batuhankemal/Development-of-an-infrared-array-sensor-integrated-laser-system/Data/Agar_Hyperthermia_ Algorithm_Validation_Experiment/Agar_Hyperthermia_ Algorithm_Validation_Experiment_16042024_R1.xlsx

Sheet: EXPERIMENT1
Current | 5.116 | IR_Temp | 25.4
Current | 5.116 | IR_Temp | 24.8
Current | 5.116 | IR_Temp | 25.4
Current | 5.116 | IR_Temp | 25.3
Current | 5.129 | IR_Temp | 24.8
Current | 5.129 | IR_Temp | 25.4
Current | 5.129 | IR_Temp | 25.1
Current | 5.129 | IR_Temp | 25.5
Current | 5.129 | IR_Temp | 24.9
Current | 5.129 | IR_Temp | 25.8
Current | 5.129 | IR_Temp | 25.6
Current | 5.136 | IR_Temp | 25.1
Current | 5.136 | IR_Temp | 25.5
Current | 5.149 | IR_Temp | 25.3
Current | 5.149 | IR_Temp | 25.2
Current | 5.155 | IR_Temp | 25.1
Current | 5.155 | IR_Temp | 25.8
Current | 5.149 | IR_Temp | 24.5
Current | 5.149 | IR_Temp | 25.5
Current | 5.155 | IR_Temp | 26.2
Current | 5.155 | IR_Temp | 25.5
Current | 5.142 | IR_Temp | 26
Current | 5.142 | IR_Temp | 26.1
Current | 5.168 | IR_Temp | 25.5
Current | 5.175 | IR_Temp | 26.2
Current | 5.188 | IR_Temp | 26.4
Current | 5.175 | IR_Temp | 26.1
Current | 5.155 | IR_Temp | 26.3
Current | 5.155 | IR_Temp | 26
Current | 5.149 | IR_Temp | 26.5
Current | 5.149 | IR_Temp | 25.7
Current | 5.149 | IR_Temp | 25.9
Current | 5.149 | IR_Temp | 25.9
Current | 5.142 | IR_Temp | 25.9
Current | 5.136 | IR_Temp | 26.2
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
