batuhankemal/Development-of-an-infrared-array-sensor-integrated-laser-system/Data/Lamb_liver_experiments/Lamb_Liver_50C_ Experiment/Lamb_Liver_50C_ Experiment_14042024_R1.xlsx

Sheet: EXPERIMENT1
Current | 5.123 | IR_Temp | 20.8
Current | 5.129 | IR_Temp | 21.2
Current | 5.136 | IR_Temp | 22.7
Current | 5.136 | IR_Temp | 22.7
Current | 5.136 | IR_Temp | 24.4
Current | 5.136 | IR_Temp | 25.4
Current | 5.136 | IR_Temp | 26.4
Current | 5.116 | IR_Temp | 27.1
Current | 5.123 | IR_Temp | 27.9
Current | 5.129 | IR_Temp | 28.7
Current | 5.129 | IR_Temp | 30
Current | 5.129 | IR_Temp | 30.3
Current | 5.129 | IR_Temp | 31.5
Current | 5.136 | IR_Temp | 31.8
Current | 5.136 | IR_Temp | 32.2
Current | 5.142 | IR_Temp | 32.5
Current | 5.136 | IR_Temp | 34
Current | 4.609 | IR_Temp | 34.8
Current | 4.615 | IR_Temp | 34.7
Current | 3.417 | IR_Temp | 35.8
Current | 3.222 | IR_Temp | 36.4
Current | 2.747 | IR_Temp | 36.7
Current | 2.936 | IR_Temp | 37.6
Current | 3.411 | IR_Temp | 38.2
Current | 3.216 | IR_Temp | 38.8
Current | 4.902 | IR_Temp | 40
Current | 2.747 | IR_Temp | 39.2
Current | 4.908 | IR_Temp | 39.7
Current | 2.942 | IR_Temp | 40.9
Current | 2.753 | IR_Temp | 41.4
Current | 2.76 | IR_Temp | 42.2
Current | 4.902 | IR_Temp | 42.4
Current | 3.945 | IR_Temp | 43
Current | 3.704 | IR_Temp | 42.7
Current | 2.519 | IR_Temp | 43.2
Current | 4.14 | IR_Temp | 43.7
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
