batuhankemal/Development-of-an-infrared-array-sensor-integrated-laser-system/Data/Lamb_liver_experiments/Lamb_Liver_50C_ Experiment/Lamb_Liver_50C_ Experiment_Constant_Power_15042024_R1.xlsx

Sheet: EXPERIMENT1
Current | 2.819 | IR_Temp | 20.9
Current | 2.825 | IR_Temp | 21.3
Current | 2.825 | IR_Temp | 22.1
Current | 2.825 | IR_Temp | 22.4
Current | 2.825 | IR_Temp | 22.6
Current | 2.825 | IR_Temp | 22.6
Current | 2.825 | IR_Temp | 23.5
Current | 2.832 | IR_Temp | 23
Current | 2.832 | IR_Temp | 24.6
Current | 2.832 | IR_Temp | 24.9
Current | 2.838 | IR_Temp | 25
Current | 2.838 | IR_Temp | 24.8
Current | 2.825 | IR_Temp | 25.4
Current | 2.819 | IR_Temp | 25.8
Current | 2.812 | IR_Temp | 26.1
Current | 2.819 | IR_Temp | 26.3
Current | 2.819 | IR_Temp | 26.5
Current | 2.819 | IR_Temp | 27.1
Current | 2.819 | IR_Temp | 26.6
Current | 2.825 | IR_Temp | 27.4
Current | 2.825 | IR_Temp | 27.6
Current | 2.825 | IR_Temp | 27.5
Current | 2.825 | IR_Temp | 28.5
Current | 2.825 | IR_Temp | 28.5
Current | 2.825 | IR_Temp | 28.5
Current | 2.832 | IR_Temp | 28.1
Current | 2.832 | IR_Temp | 29.2
Current | 2.832 | IR_Temp | 29.4
Current | 2.838 | IR_Temp | 29.1
Current | 2.832 | IR_Temp | 30
Current | 2.845 | IR_Temp | 29.9
Current | 2.858 | IR_Temp | 29.7
Current | 2.851 | IR_Temp | 30.1
Current | 2.851 | IR_Temp | 30.1
Current | 2.851 | IR_Temp | 30.3
Current | 2.851 | IR_Temp | 30.4
Current | 2.851 | IR_Temp | 30.3
Current | 2.851 | IR_Temp | 30.5
Current | 2.851 | IR_Temp | 31.1
Current | 2.851 | IR_Temp | 30.6
Current | 2.851 | IR_Temp | 30.6
Current | 2.851 | IR_Temp | 31.2
Current | 2.858 | IR_Temp | 31
Current | 2.858 | IR_Temp | 31.3
Current | 2.851 | IR_Temp | 31.6
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
 |  | IR_Temp | 49.5
 |  | IR_Temp | 49.5
 |  | IR_Temp | 49.6
 |  | IR_Temp | 48.9
 |  | IR_Temp | 49.4
 |  | IR_Temp | 49.5
 |  | IR_Temp | 49.1
 |  | IR_Temp | 49.5
 |  | IR_Temp | 49.5
 |  | IR_Temp | 49.4
 |  | IR_Temp | 49.8
 |  | IR_Temp | 49.3
 |  | IR_Temp | 49.7
 |  | IR_Temp | 49.8

Sheet: EXPERIMENT2
Current | 2.825 | IR_Temp | 20.7
Current | 2.825 | IR_Temp | 21
Current | 2.825 | IR_Temp | 21.9
Current | 2.838 | IR_Temp | 22
Current | 2.838 | IR_Temp | 22.2
Current | 2.825 | IR_Temp | 23.2
Current | 2.825 | IR_Temp | 23.2
Current | 2.832 | IR_Temp | 23.2
Current | 2.845 | IR_Temp | 24.1
Current | 2.838 | IR_Temp | 24.2
Current | 2.845 | IR_Temp | 25
Current | 2.832 | IR_Temp | 24.8
Current | 2.832 | IR_Temp | 25.2
Current | 2.825 | IR_Temp | 25.7
Current | 2.825 | IR_Temp | 26.2
Current | 2.832 | IR_Temp | 26.3
Current | 2.838 | IR_Temp | 26.2
Current | 2.838 | IR_Temp | 26.8
Current | 2.838 | IR_Temp | 26.9
Current | 2.832 | IR_Temp | 27.6
Current | 2.838 | IR_Temp | 27.5
Current | 2.838 | IR_Temp | 27.1
Current | 2.838 | IR_Temp | 27.7
Current | 2.832 | IR_Temp | 27.8
Current | 2.838 | IR_Temp | 28.9
Current | 2.851 | IR_Temp | 29
Current | 2.845 | IR_Temp | 28.8
Current | 2.838 | IR_Temp | 29.5
Current | 2.845 | IR_Temp | 28.6
Current | 2.845 | IR_Temp | 29.3
Current | 2.838 | IR_Temp | 29.7
Current | 2.845 | IR_Temp | 30.2
Current | 2.845 | IR_Temp | 30
Current | 2.838 | IR_Temp | 29.8
Current | 2.845 | IR_Temp | 30.3
Current | 2.851 | IR_Temp | 30.3
Current | 2.851 | IR_Temp | 30.9
Current | 2.851 | IR_Temp | 30.8
Current | 2.851 | IR_Temp | 30.8
Current | 2.851 | IR_Temp | 30.7
Current | 2.858 | IR_Temp | 31.7
Current | 2.851 | IR_Temp | 31.2
Current | 2.851 | IR_Temp | 31
Current | 2.845 | IR_Temp | 31.3
Current | 2.845 | IR_Temp | 32.2
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
 |  | IR_Temp | 49
 |  | IR_Temp | 48.7
 |  | IR_Temp | 48.5
 |  | IR_Temp | 49.1
 |  | IR_Temp | 48.5
 |  | IR_Temp | 48.9
 |  | IR_Temp | 48.7
 |  | IR_Temp | 48.8
 |  | IR_Temp | 49.5
 |  | IR_Temp | 48.8
 |  | IR_Temp | 48.9
 |  | IR_Temp | 49
 |  | IR_Temp | 49.1
 |  | IR_Temp | 48.9
 |  | IR_Temp | 48.8
 |  | IR_Temp | 48.9

Sheet: EXPERIMENT3
Current | 2.799 | IR_Temp | 21.3
Current | 2.812 | IR_Temp | 21.4
Current | 2.838 | IR_Temp | 22.5
Current | 2.838 | IR_Temp | 22.6
Current | 2.845 | IR_Temp | 22.9
Current | 2.845 | IR_Temp | 23.2
Current | 2.845 | IR_Temp | 23.9
Current | 2.845 | IR_Temp | 23.3
Current | 2.845 | IR_Temp | 24.3
Current | 2.819 | IR_Temp | 24.4
Current | 2.825 | IR_Temp | 25.2
Current | 2.825 | IR_Temp | 25
Current | 2.825 | IR_Temp | 24.8
Current | 2.825 | IR_Temp | 25.5
Current | 2.832 | IR_Temp | 26.1
Current | 2.832 | IR_Temp | 26
Current | 2.851 | IR_Temp | 25.5
Current | 2.851 | IR_Temp | 26.2
Current | 2.838 | IR_Temp | 27.1
Current | 2.858 | IR_Temp | 27.4
Current | 2.845 | IR_Temp | 26.6
Current | 2.838 | IR_Temp | 28
Current | 2.832 | IR_Temp | 27.6
Current | 2.838 | IR_Temp | 27.6
Current | 2.838 | IR_Temp | 28.4
Current | 2.838 | IR_Temp | 28.5
Current | 2.845 | IR_Temp | 29.1
Current | 2.838 | IR_Temp | 28.2
Current | 2.845 | IR_Temp | 28.1
Current | 2.845 | IR_Temp | 29.7
Current | 2.838 | IR_Temp | 29.6
Current | 2.845 | IR_Temp | 29.8
Current | 2.838 | IR_Temp | 29.7
Current | 2.851 | IR_Temp | 29.6
Current | 2.851 | IR_Temp | 30.4
Current | 2.845 | IR_Temp | 30.4
Current | 2.845 | IR_Temp | 30.4
Current | 2.845 | IR_Temp | 30.9
Current | 2.845 | IR_Temp | 30.7
Current | 2.845 | IR_Temp | 30.9
Current | 2.845 | IR_Temp | 31.7
Current | 2.845 | IR_Temp | 31.2
Current | 2.845 | IR_Temp | 31.3
Current | 2.851 | IR_Temp | 31.7
Current | 2.845 | IR_Temp | 31.6
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
 |  | IR_Temp | 49.3
 |  | IR_Temp | 49.7
 |  | IR_Temp | 49.6
 |  | IR_Temp | 49.6
 |  | IR_Temp | 49.9
 |  | IR_Temp | 49.4
 |  | IR_Temp | 49.2
 |  | IR_Temp | 49.6
 |  | IR_Temp | 49.7
 |  | IR_Temp | 49.9
 |  | IR_Temp | 49
 |  | IR_Temp | 49.3
 |  | IR_Temp | 49.6
 |  | IR_Temp | 49.2

Sheet: EXPERIMENT4
Current | 2.812 | IR_Temp | 19.9
Current | 2.819 | IR_Temp | 20.5
Current | 2.819 | IR_Temp | 21
Current | 2.819 | IR_Temp | 21.2
Current | 2.825 | IR_Temp | 21.8
Current | 2.819 | IR_Temp | 22.2
Current | 2.825 | IR_Temp | 22
Current | 2.825 | IR_Temp | 23.1
Current | 2.832 | IR_Temp | 23
Current | 2.825 | IR_Temp | 24
Current | 2.825 | IR_Temp | 23.5
Current | 2.832 | IR_Temp | 24
Current | 2.832 | IR_Temp | 25
Current | 2.832 | IR_Temp | 25.1
Current | 2.832 | IR_Temp | 25.3
Current | 2.832 | IR_Temp | 25
Current | 2.838 | IR_Temp | 25.4
Current | 2.832 | IR_Temp | 26.1
Current | 2.832 | IR_Temp | 26.1
Current | 2.832 | IR_Temp | 25.8
Current | 2.832 | IR_Temp | 26.1
Current | 2.838 | IR_Temp | 26.3
Current | 2.838 | IR_Temp | 27.8
Current | 2.838 | IR_Temp | 28
Current | 2.845 | IR_Temp | 27.2
Current | 2.838 | IR_Temp | 28.3
Current | 2.838 | IR_Temp | 28.2
Current | 2.845 | IR_Temp | 28.3
Current | 2.838 | IR_Temp | 29.4
Current | 2.838 | IR_Temp | 28.7
Current | 2.838 | IR_Temp | 29.3
Current | 2.838 | IR_Temp | 29.3
Current | 2.845 | IR_Temp | 29.7
Current | 2.845 | IR_Temp | 29.6
Current | 2.838 | IR_Temp | 29.9
Current | 2.845 | IR_Temp | 30.2
Current | 2.851 | IR_Temp | 30
Current | 2.838 | IR_Temp | 30.4
Current | 2.845 | IR_Temp | 30.4
Current | 2.832 | IR_Temp | 30.3
Current | 2.832 | IR_Temp | 30.7
Current | 2.825 | IR_Temp | 31.1
Current | 2.832 | IR_Temp | 30.9
Current | 2.832 | IR_Temp | 31.2
Current | 2.832 | IR_Temp | 31.2
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
 |  | IR_Temp | 51.1
 |  | IR_Temp | 50.5
 |  | IR_Temp | 50.9
 |  | IR_Temp | 50.6
 |  | IR_Temp | 50.7
 |  | IR_Temp | 50.5
 |  | IR_Temp | 50.1
 |  | IR_Temp | 50.6
 |  | IR_Temp | 49.9
 |  | IR_Temp | 50.6
 |  | IR_Temp | 50.6
 |  | IR_Temp | 51
 |  | IR_Temp | 50.9
 |  | IR_Temp | 50.6
