batuhankemal/Development-of-an-infrared-array-sensor-integrated-laser-system/Data/Lamb_liver_experiments/Lamb_Liver_60C_ Experiment/Lamb_Liver_60C_ Experiment_14042024_R1.xlsx

Sheet: EXPERIMENT1
Current | 5.11 | IR_Temp | 21.2
Current | 5.116 | IR_Temp | 21.7
Current | 5.116 | IR_Temp | 22.4
Current | 5.123 | IR_Temp | 23.3
Current | 5.129 | IR_Temp | 24.4
Current | 5.129 | IR_Temp | 25.4
Current | 5.136 | IR_Temp | 26.1
Current | 5.136 | IR_Temp | 27.2
Current | 5.136 | IR_Temp | 28.2
Current | 5.142 | IR_Temp | 28.7
Current | 5.149 | IR_Temp | 29.6
Current | 5.142 | IR_Temp | 30.1
Current | 5.11 | IR_Temp | 31.1
Current | 5.116 | IR_Temp | 31.8
Current | 5.142 | IR_Temp | 33.1
Current | 5.136 | IR_Temp | 33
Current | 5.136 | IR_Temp | 34.2
Current | 5.136 | IR_Temp | 34.2
Current | 5.142 | IR_Temp | 34.7
Current | 5.155 | IR_Temp | 35.5
Current | 5.162 | IR_Temp | 35.9
Current | 5.168 | IR_Temp | 36.8
Current | 5.168 | IR_Temp | 36.9
Current | 5.155 | IR_Temp | 37.4
Current | 5.142 | IR_Temp | 38.3
Current | 5.142 | IR_Temp | 38
Current | 5.149 | IR_Temp | 39.6
Current | 5.149 | IR_Temp | 39.8
Current | 5.142 | IR_Temp | 40.4
Current | 5.149 | IR_Temp | 41
Current | 5.155 | IR_Temp | 41.4
Current | 5.162 | IR_Temp | 41.8
Current | 5.168 | IR_Temp | 41.6
Current | 5.175 | IR_Temp | 42.5
Current | 5.181 | IR_Temp | 42.4
Current | 5.181 | IR_Temp | 42.8
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
