batuhankemal/Development-of-an-infrared-array-sensor-integrated-laser-system/Data/Lamb_liver_experiments/Lamb_Liver_50C_ Experiment/Lamb_Liver_50C_ Whole_Surface.xlsx

Sheet: EXPERIMENT1
21.1 | 22.2 | 23.8 | 25.2 | 23.7 | 25.2 | 24.6 | 23.8 | 25.4 | 23.9 | 27.1 | 25.3 | 26.3 | 26 | 27.1 | 25.7 | 25.4 | 26.6 | 26.2 | 26.3 | 25.4 | 24.6 | 23 | 23.6 | 22.4 | 24.1 | 23.5 | 22 | 23.8 | 23 | 22.5 | 23.7
23.3 | 23.7 | 23.9 | 24.8 | 24.3 | 24.8 | 27 | 26 | 27.1 | 25.9 | 25.9 | 26.7 | 26.8 | 27.6 | 27.2 | 27.7 | 27.3 | 26.4 | 28.7 | 27.3 | 27.5 | 26.2 | 24.7 | 24.8 | 24 | 23.7 | 23.3 | 23.2 | 22 | 25.3 | 23.9 | 24.5
23.8 | 24.9 | 24.4 | 24.1 | 25.5 | 26.3 | 25.9 | 26.1 | 27.1 | 27.3 | 25.8 | 26.7 | 28.6 | 28.3 | 29.5 | 28.6 | 28.7 | 29.2 | 28.8 | 28 | 28.6 | 27.2 | 25.5 | 24.4 | 24.6 | 23.5 | 24.7 | 23.1 | 22.8 | 23.7 | 23.5 | 25
23.1 | 24.9 | 26.1 | 24.8 | 26 | 25 | 26.8 | 27.6 | 26 | 28.7 | 27.6 | 28.1 | 30.7 | 31.3 | 29.6 | 29.4 | 30.6 | 29.4 | 30.6 | 29.3 | 28.7 | 28 | 27.3 | 28.2 | 27.4 | 25.4 | 24 | 24.6 | 22.7 | 24.3 | 24.4 | 22.4
24.3 | 23.3 | 23.5 | 24.8 | 24.5 | 25.8 | 27.2 | 27.6 | 26.5 | 29.1 | 30.1 | 30.6 | 30.2 | 31.3 | 30.9 | 32.6 | 30.7 | 31 | 30.1 | 31 | 29.7 | 28.7 | 28.3 | 27.1 | 26.1 | 26.3 | 24.9 | 23 | 25.3 | 24.1 | 24.6 | 24
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
