batuhankemal/Development-of-an-infrared-array-sensor-integrated-laser-system/Hardware/IR Array Unit Hardware/IR_ARRAY_IMG.brd

## EAGLE design Hardware/IR Array Unit Hardware/IR_ARRAY_IMG.brd (2024-10-23)

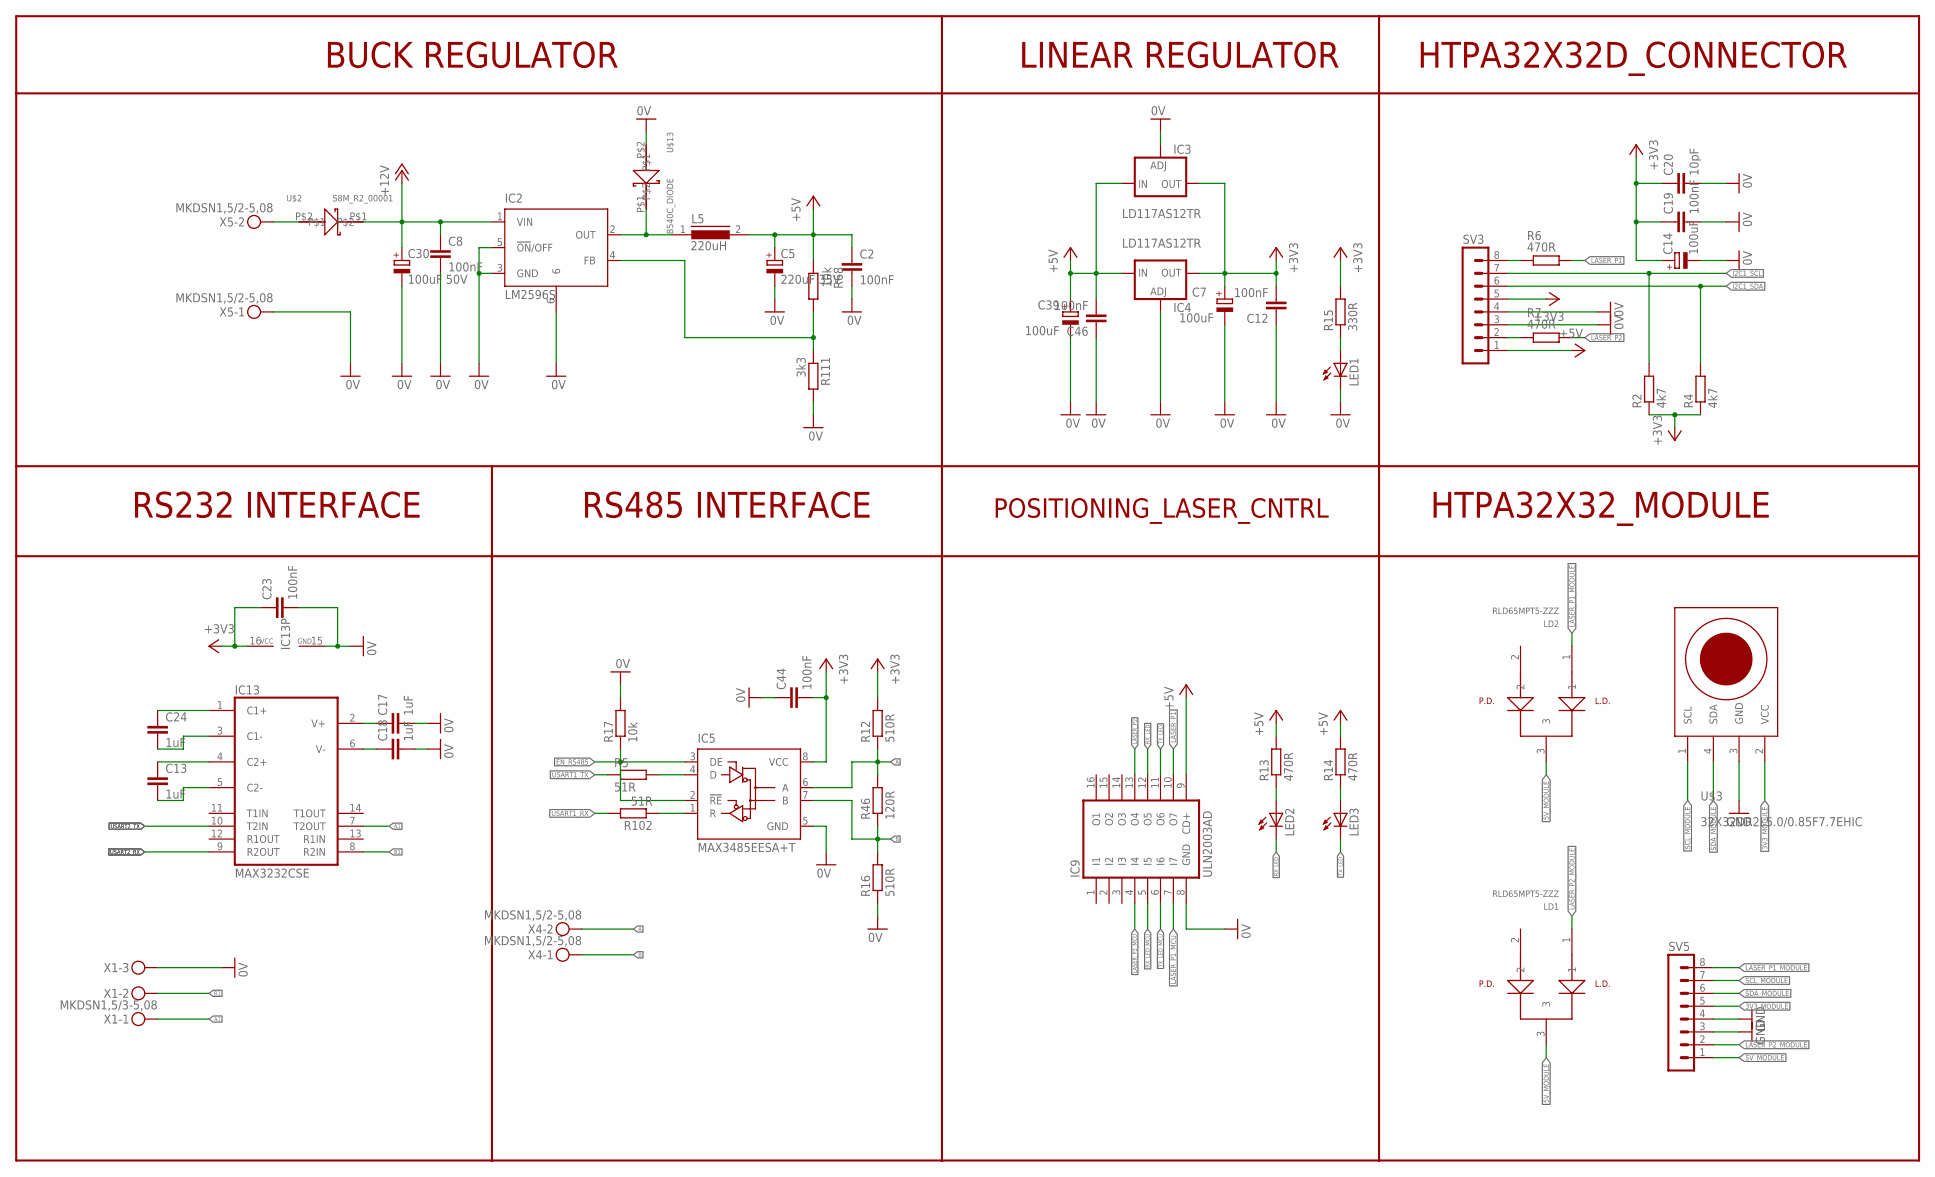
[picture p1: schematic IR_ARRAY_IMG.sch, sheet 1]

Parts:
C2, C8: 100nF; C0805
C5: 220uF 35V; 153CLV-0810
C7, C39: 100uF; 153CLV-0605
C12, C19, C23, C44, C46: 100nF; C0603
C13, C17, C18, C24: 1uF; C1206
C14: 100uF; C/6032-28R
C20: 10pF; C0603
C30: 100uF 50V; 153CLV-0810
IC2: LM2596S; TO263-5
IC3, IC4: LD117AS12TR; SOT223
IC5: MAX3485EESA+T; D_R-PDSO-G8
IC9: ULN2003AD; SO16
IC13: MAX3232CSE; SO16
L5: 220uH; DR125
LD1, LD2: RLD65MPT5-ZZZ
LED1, LED2, LED3: LEDCHIPLED_0805; CHIPLED_0805
R2, R4: 4k7; R0603
R5, R102: 51R; R0603
R6, R7: 470R; M0805
R12, R16: 510R; R0603
R13, R14: 470R; R0603
R15: 330R; R0603
R17: 10k; R0603
R46: 120R; R0603
R68: 10k; M0805
R111: 3k3; M0805
SV3, SV5: MA08-1
U$2: S8M_R2_00001; SMC
U$3: 32X32DR2L5.0/0.85F7.7EHIC
U$13: B540C_DIODE; SMC
X1: MKDSN1,5/3-5,08
X4, X5: MKDSN1,5/2-5,08

Connections:
0V: C2.2, C5.-, C7.-, C8.2, C12.1, C14.-, C17.2, C18.2, C19.2, C20.2, C23.2, C30.-, C39.-, C44.1, C46.1, IC2.3 (GND), IC2.5 (!ON!/OFF), IC2.6, IC3.1 (ADJ), IC4.1 (ADJ), IC5.5 (GND), IC9.8 (GND), IC13.15 (GND), LED1.C, R16.1, R17.2, R111.2, SV3.3, SV3.4, U$13.P$2, X1.3, X5.1; also elsewhere on the board
3V3_MODULE: SV5.5, U$3.2 (VCC)
5V_MODULE: LD1.3, LD2.3, SV5.1
+3V3: C7.+, C12.2, C14.+, C19.1, C20.1, C23.1, C44.2, IC3.4 (OUT), IC4.4 (OUT), IC5.8 (VCC), IC13.16 (VCC), R2.1, R4.1, R12.2, R15.2, SV3.5; also elsewhere on the board
+5V: C2.1, C5.+, C39.+, C46.2, IC3.3 (IN), IC4.3 (IN), IC9.9 (CD+), L5.2, R13.2, R14.2, R68.1, SV3.1
+12V: C8.1, C30.+, IC2.1 (VIN), U$2.P$1
A: IC5.6 (A), R12.1, R46.2, X4.2
A1: IC13.7 (T2OUT), X1.1
B: IC5.7 (B), R16.2, R46.1, X4.1
B1: IC13.8 (R2IN), X1.2
EN_RS485: IC5.2 (!RE), IC5.3 (DE), R17.1; also elsewhere on the board
GND: SV5.3, SV5.4, U$3.3 (GND)
I2C1_SCL: R2.2, SV3.7; also elsewhere on the board
I2C1_SDA: R4.2, SV3.6; also elsewhere on the board
LASER_P1: IC9.10 (O7), R6.2
LASER_P1_MCU: IC9.7 (I7); also elsewhere on the board
LASER_P1_MODULE: LD2.1, SV5.8
LASER_P2: IC9.13 (O4), R7.2
LASER_P2_MCU: IC9.4 (I4); also elsewhere on the board
LASER_P2_MODULE: LD1.1, SV5.2
unnamed: U$2.P$2, X5.2
unnamed: C18.1, IC13.6 (V-)
unnamed: R7.1, SV3.2
unnamed: R6.1, SV3.8
unnamed: LED2.A, R13.1
unnamed: LED3.A, R14.1
unnamed: IC5.4 (D), R5.2
unnamed: LED1.A, R15.1
unnamed: C24.1, IC13.1 (C1+)
unnamed: C24.2, IC13.3 (C1-)
unnamed: IC5.1 (R), R102.1
unnamed: C13.1, IC13.4 (C2+)
unnamed: C13.2, IC13.5 (C2-)
unnamed: C17.1, IC13.2 (V+)
unnamed: IC2.2 (OUT), L5.1, U$13.P$1
unnamed: IC2.4 (FB), R68.2, R111.1
RX_LED: IC9.12 (O5), LED2.C
RX_LED_MCU: IC9.5 (I5); also elsewhere on the board
SCL_MODULE: SV5.7, U$3.1 (SCL)
SDA_MODULE: SV5.6, U$3.4 (SDA)
TX_LED: IC9.11 (O6), LED3.C
TX_LED_MCU: IC9.6 (I6); also elsewhere on the board
USART1_RX: R102.2; also elsewhere on the board
USART1_TX: R5.1; also elsewhere on the board
USART2_RX: IC13.9 (R2OUT); also elsewhere on the board
USART2_TX: IC13.10 (T2IN); also elsewhere on the board

Notes on the sheet:
BUCK REGULATOR
LINEAR REGULATOR
RS232 INTERFACE
RS485 INTERFACE
HTPA32X32D_CONNECTOR
HTPA32X32_MODULE
POSITIONING_LASER_CNTRL

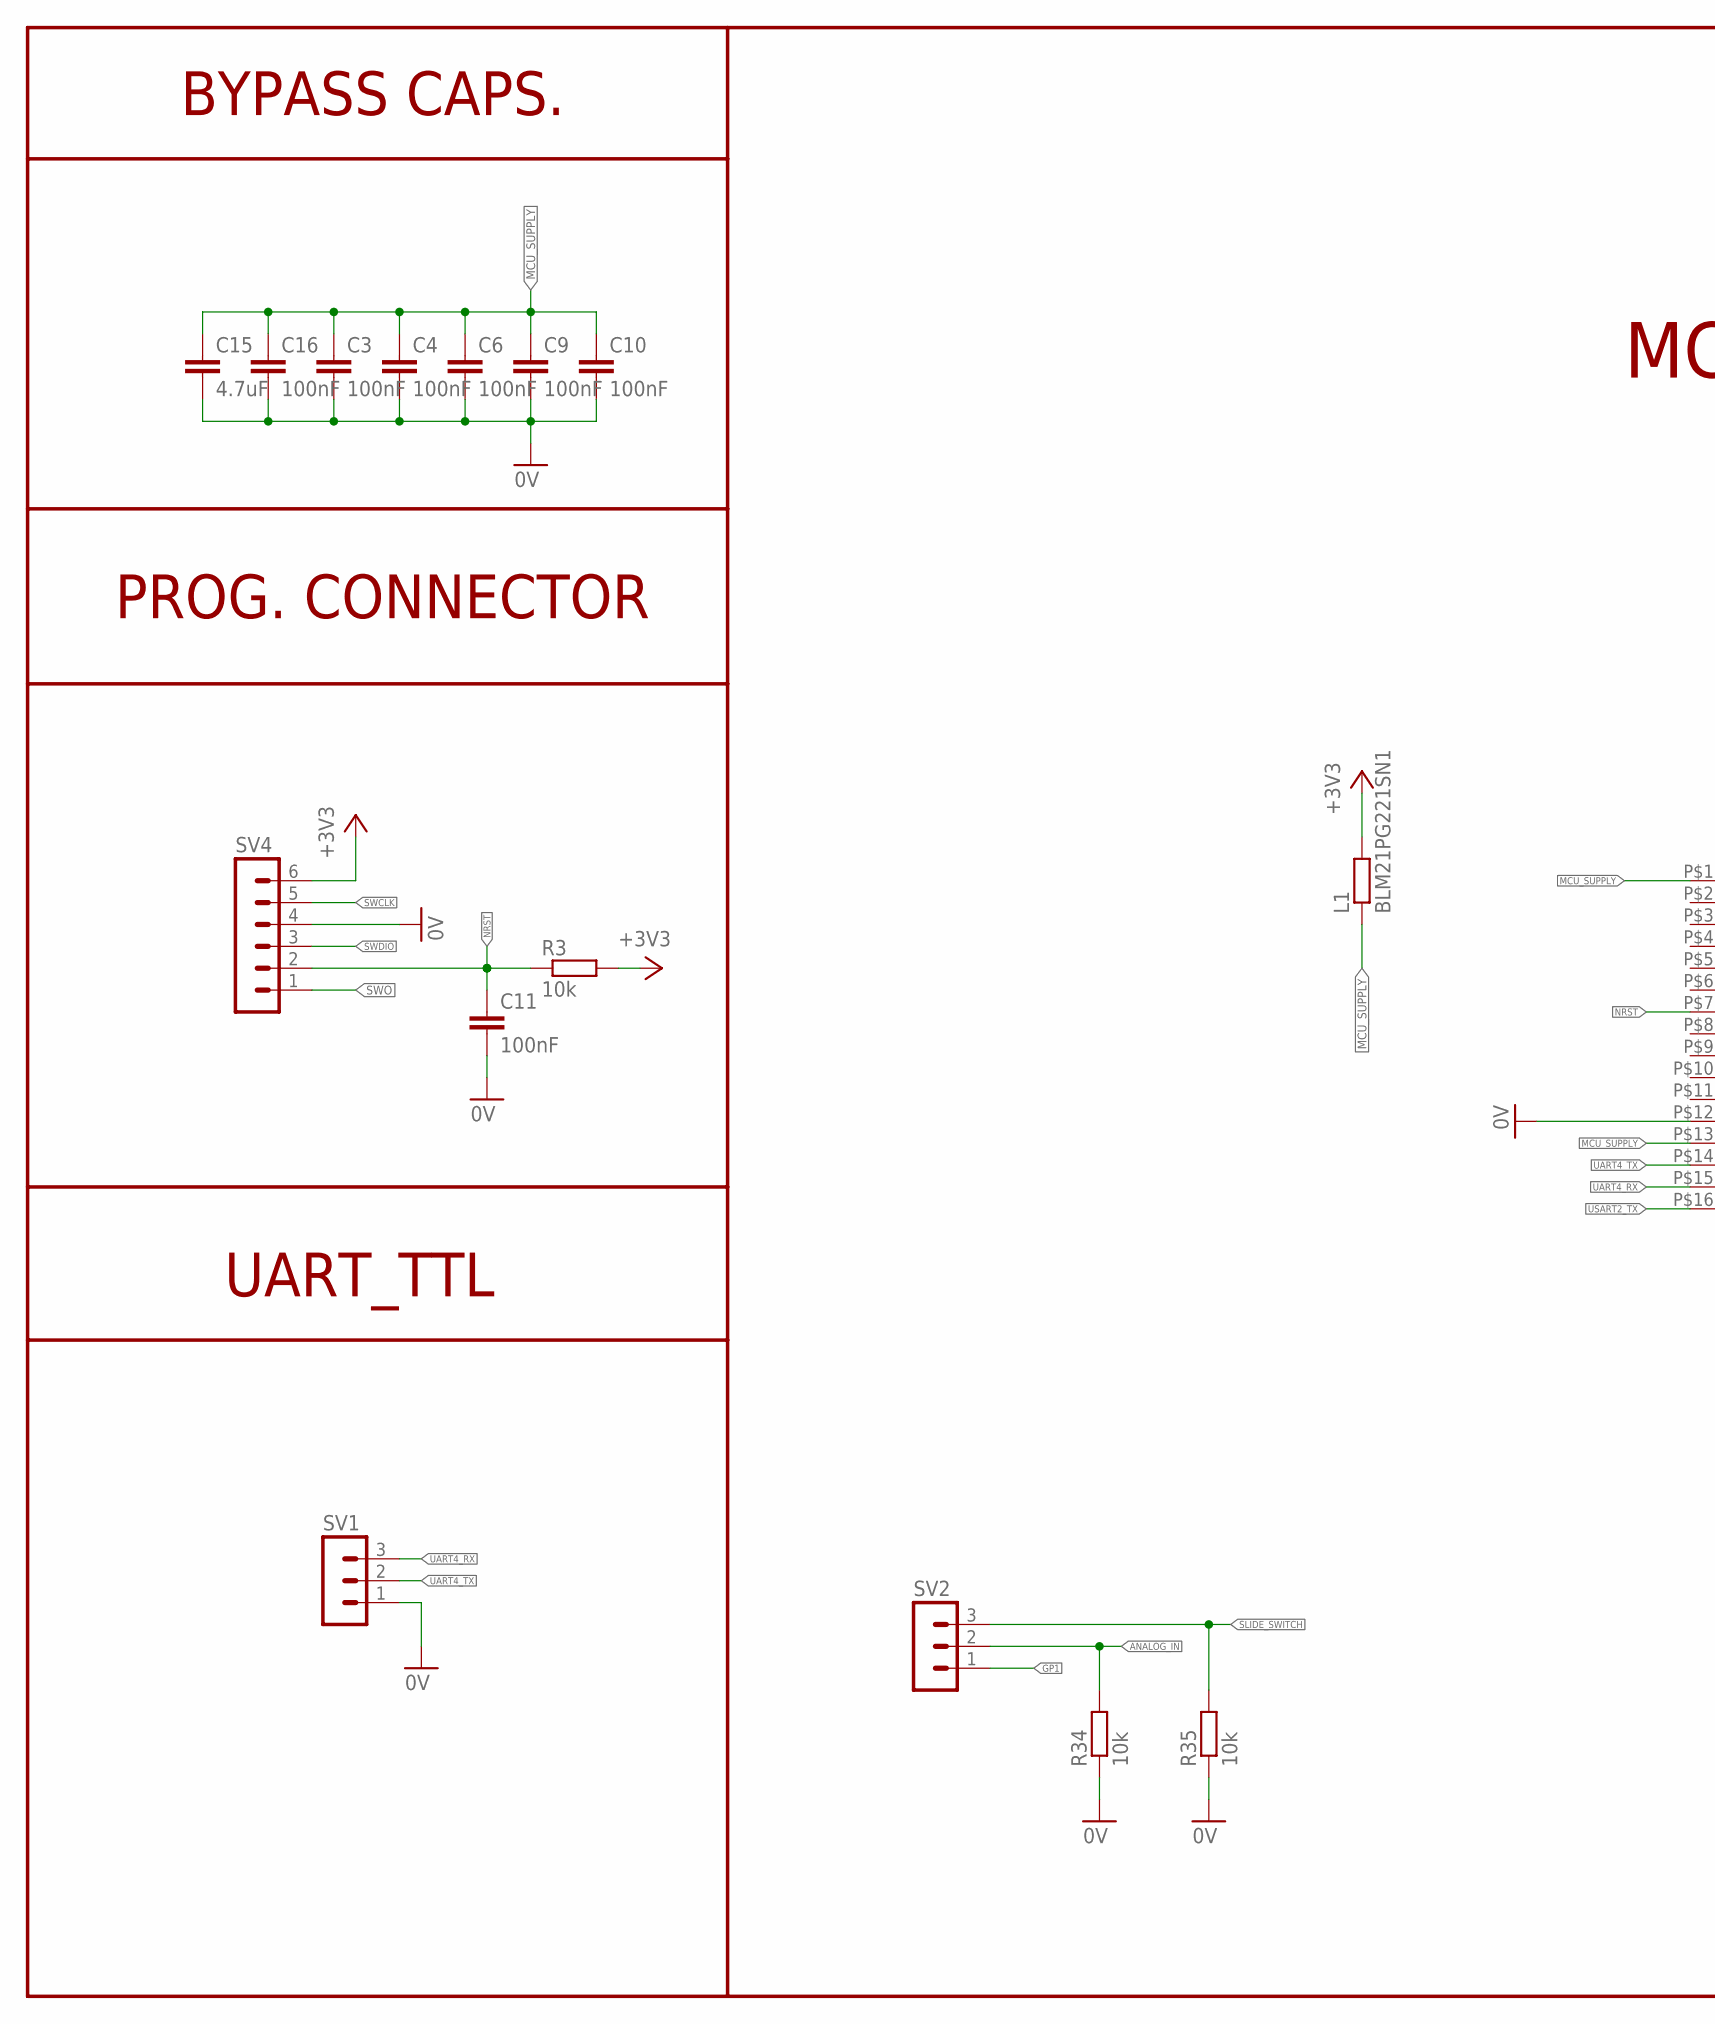
[picture p2: schematic IR_ARRAY_IMG.sch, sheet 2, part in row 1, column 1]

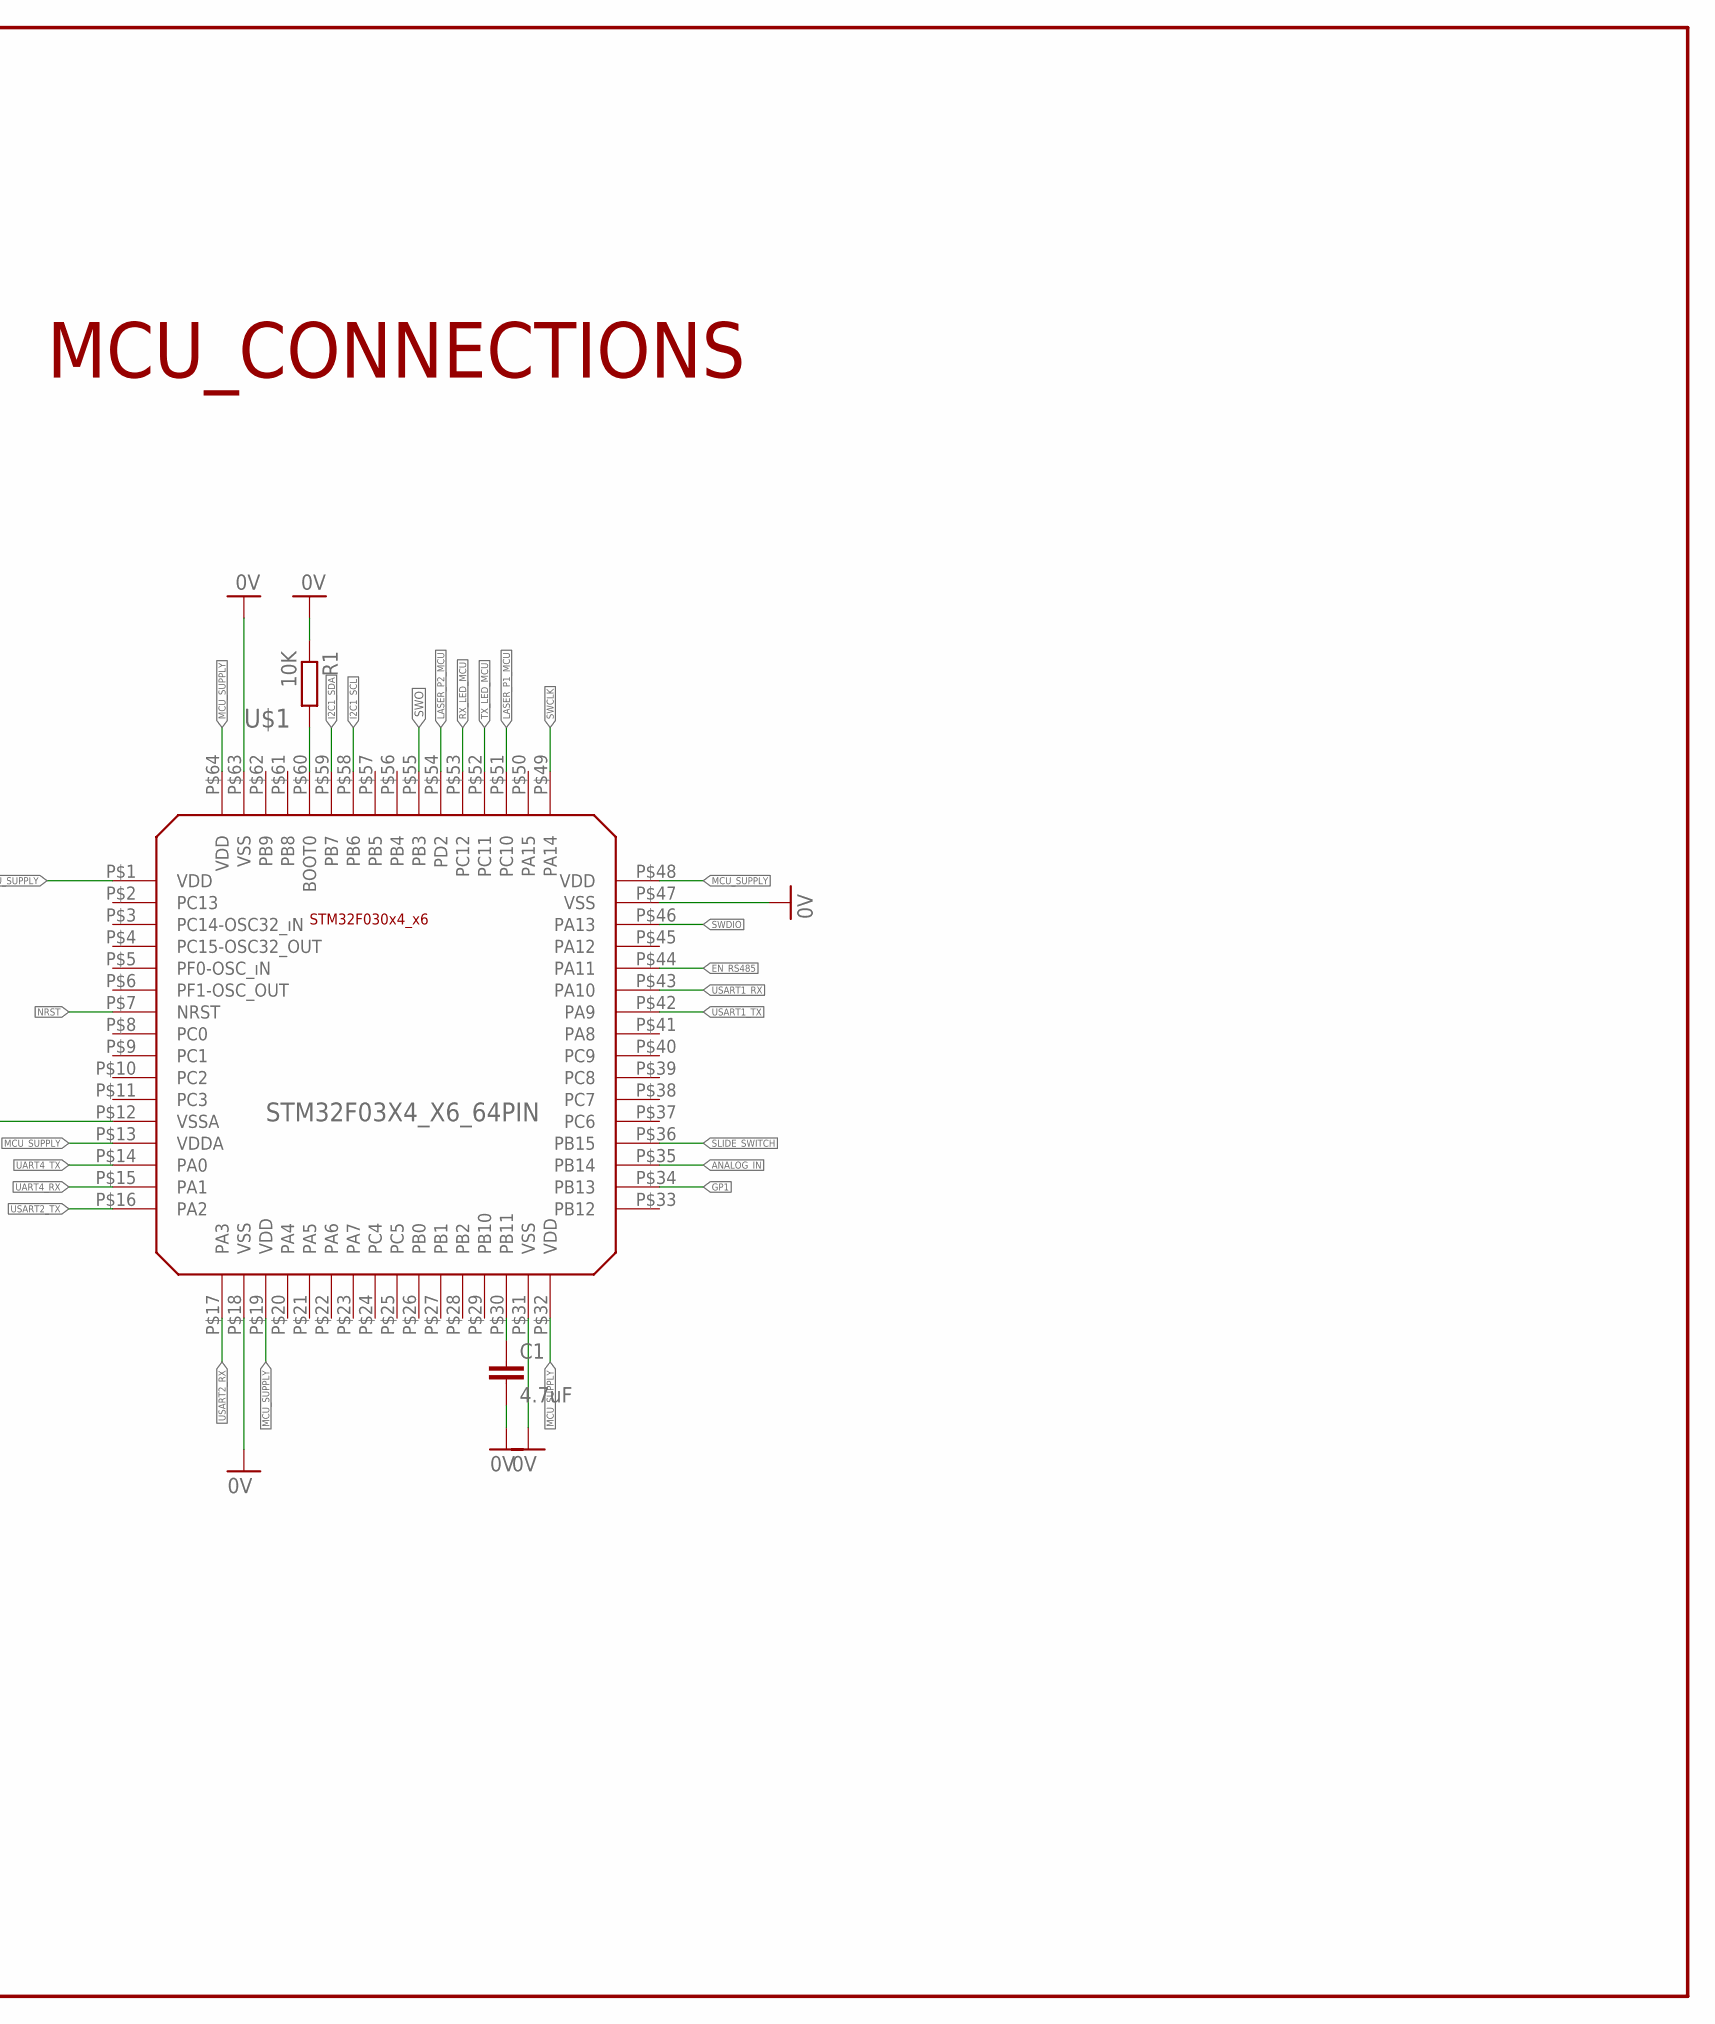
[picture p3: schematic IR_ARRAY_IMG.sch, sheet 2, part in row 1, column 2]

Parts:
C1, C15: 4.7uF; C0805
C3, C4, C6, C9, C10, C11, C16: 100nF; C0603
L1: BLM21PG221SN1; R0805
R1: 10K; R0603
R3, R34, R35: 10k; R0603
SV1, SV2: MA03-1
SV4: MA06-1
U$1: STM32F03X4_X6_64PIN; LQFP64

Connections:
0V: C1.2, C3.2, C4.2, C6.2, C9.2, C10.2, C11.2, C15.2, C16.2, R1.1, R34.1, R35.1, SV1.1, SV4.4, U$1.P$12 (VSSA), U$1.P$18 (VSS), U$1.P$31 (VSS), U$1.P$47 (VSS), U$1.P$63 (VSS); also elsewhere on the board
+3V3: L1.2, R3.2, SV4.6; also elsewhere on the board
ANALOG_IN: R34.2, SV2.2, U$1.P$35 (PB14)
EN_RS485: U$1.P$44 (PA11); also elsewhere on the board
GP1: SV2.1, U$1.P$34 (PB13)
I2C1_SCL: U$1.P$58 (PB6); also elsewhere on the board
I2C1_SDA: U$1.P$59 (PB7); also elsewhere on the board
LASER_P1_MCU: U$1.P$51 (PC10); also elsewhere on the board
LASER_P2_MCU: U$1.P$54 (PD2); also elsewhere on the board
MCU_SUPPLY: C3.1, C4.1, C6.1, C9.1, C10.1, C15.1, C16.1, L1.1, U$1.P$1 (VDD), U$1.P$13 (VDDA), U$1.P$19 (VDD), U$1.P$32 (VDD), U$1.P$48 (VDD), U$1.P$64 (VDD)
unnamed: R1.2, U$1.P$60 (BOOT0)
unnamed: C1.1, U$1.P$30 (PB11)
NRST: C11.1, R3.1, SV4.2, U$1.P$7 (NRST)
RX_LED_MCU: U$1.P$53 (PC12); also elsewhere on the board
SLIDE_SWITCH: R35.2, SV2.3, U$1.P$36 (PB15)
SWCLK: SV4.5, U$1.P$49 (PA14)
SWDIO: SV4.3, U$1.P$46 (PA13)
SWO: SV4.1, U$1.P$55 (PB3)
TX_LED_MCU: U$1.P$52 (PC11); also elsewhere on the board
UART4_RX: SV1.3, U$1.P$15 (PA1)
UART4_TX: SV1.2, U$1.P$14 (PA0)
USART1_RX: U$1.P$43 (PA10); also elsewhere on the board
USART1_TX: U$1.P$42 (PA9); also elsewhere on the board
USART2_RX: U$1.P$17 (PA3); also elsewhere on the board
USART2_TX: U$1.P$16 (PA2); also elsewhere on the board

Notes on the sheet:
BYPASS CAPS.
PROG. CONNECTOR
MCU_CONNECTIONS
UART_TTL

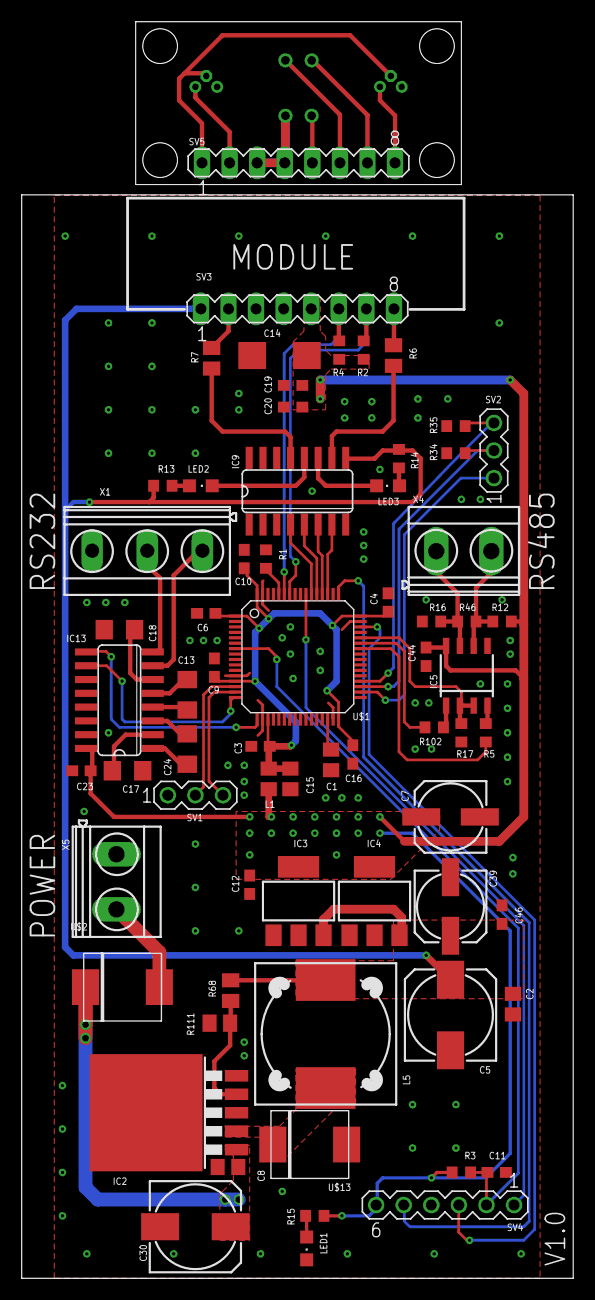
[picture p4: board IR_ARRAY_IMG.brd from above]

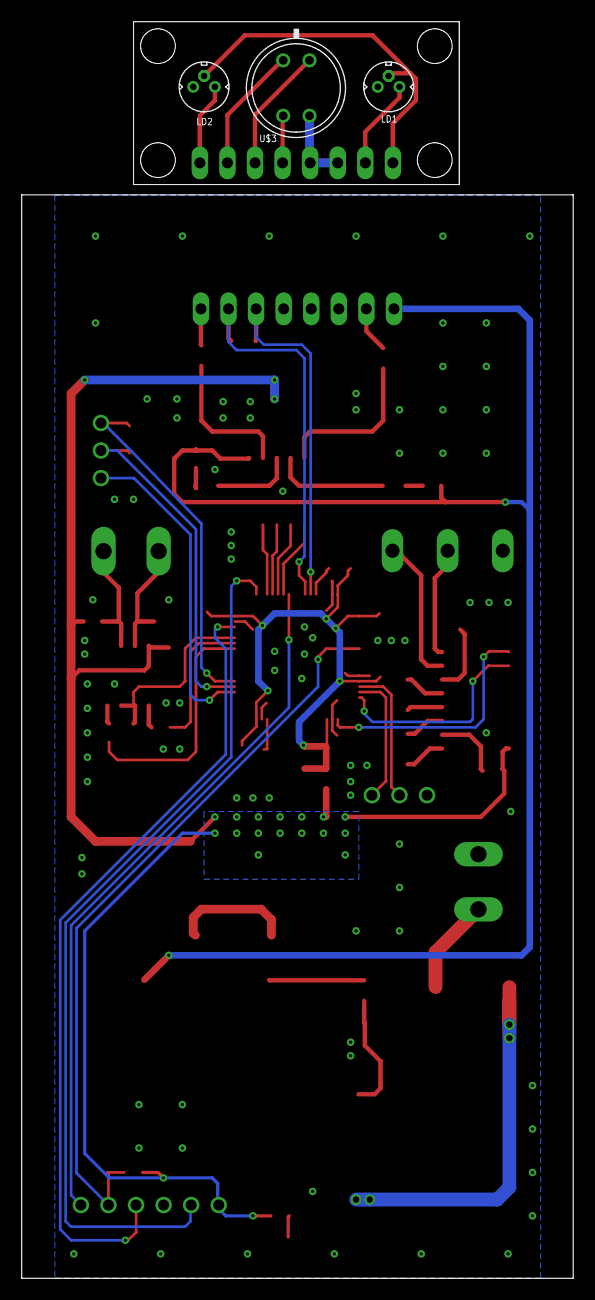
[picture p5: board IR_ARRAY_IMG.brd from below]

Board: 2 copper layers, 50.8 x 99.8 mm, 70 parts (3 on the bottom side), 58 nets.
