batuhankemal/Development-of-an-infrared-array-sensor-integrated-laser-system/Hardware/Electronic Control Unit(ECU) Hardware/LSR_CNTRL.brd

## EAGLE design Hardware/Electronic Control Unit(ECU) Hardware/LSR_CNTRL.brd (2024-10-23)

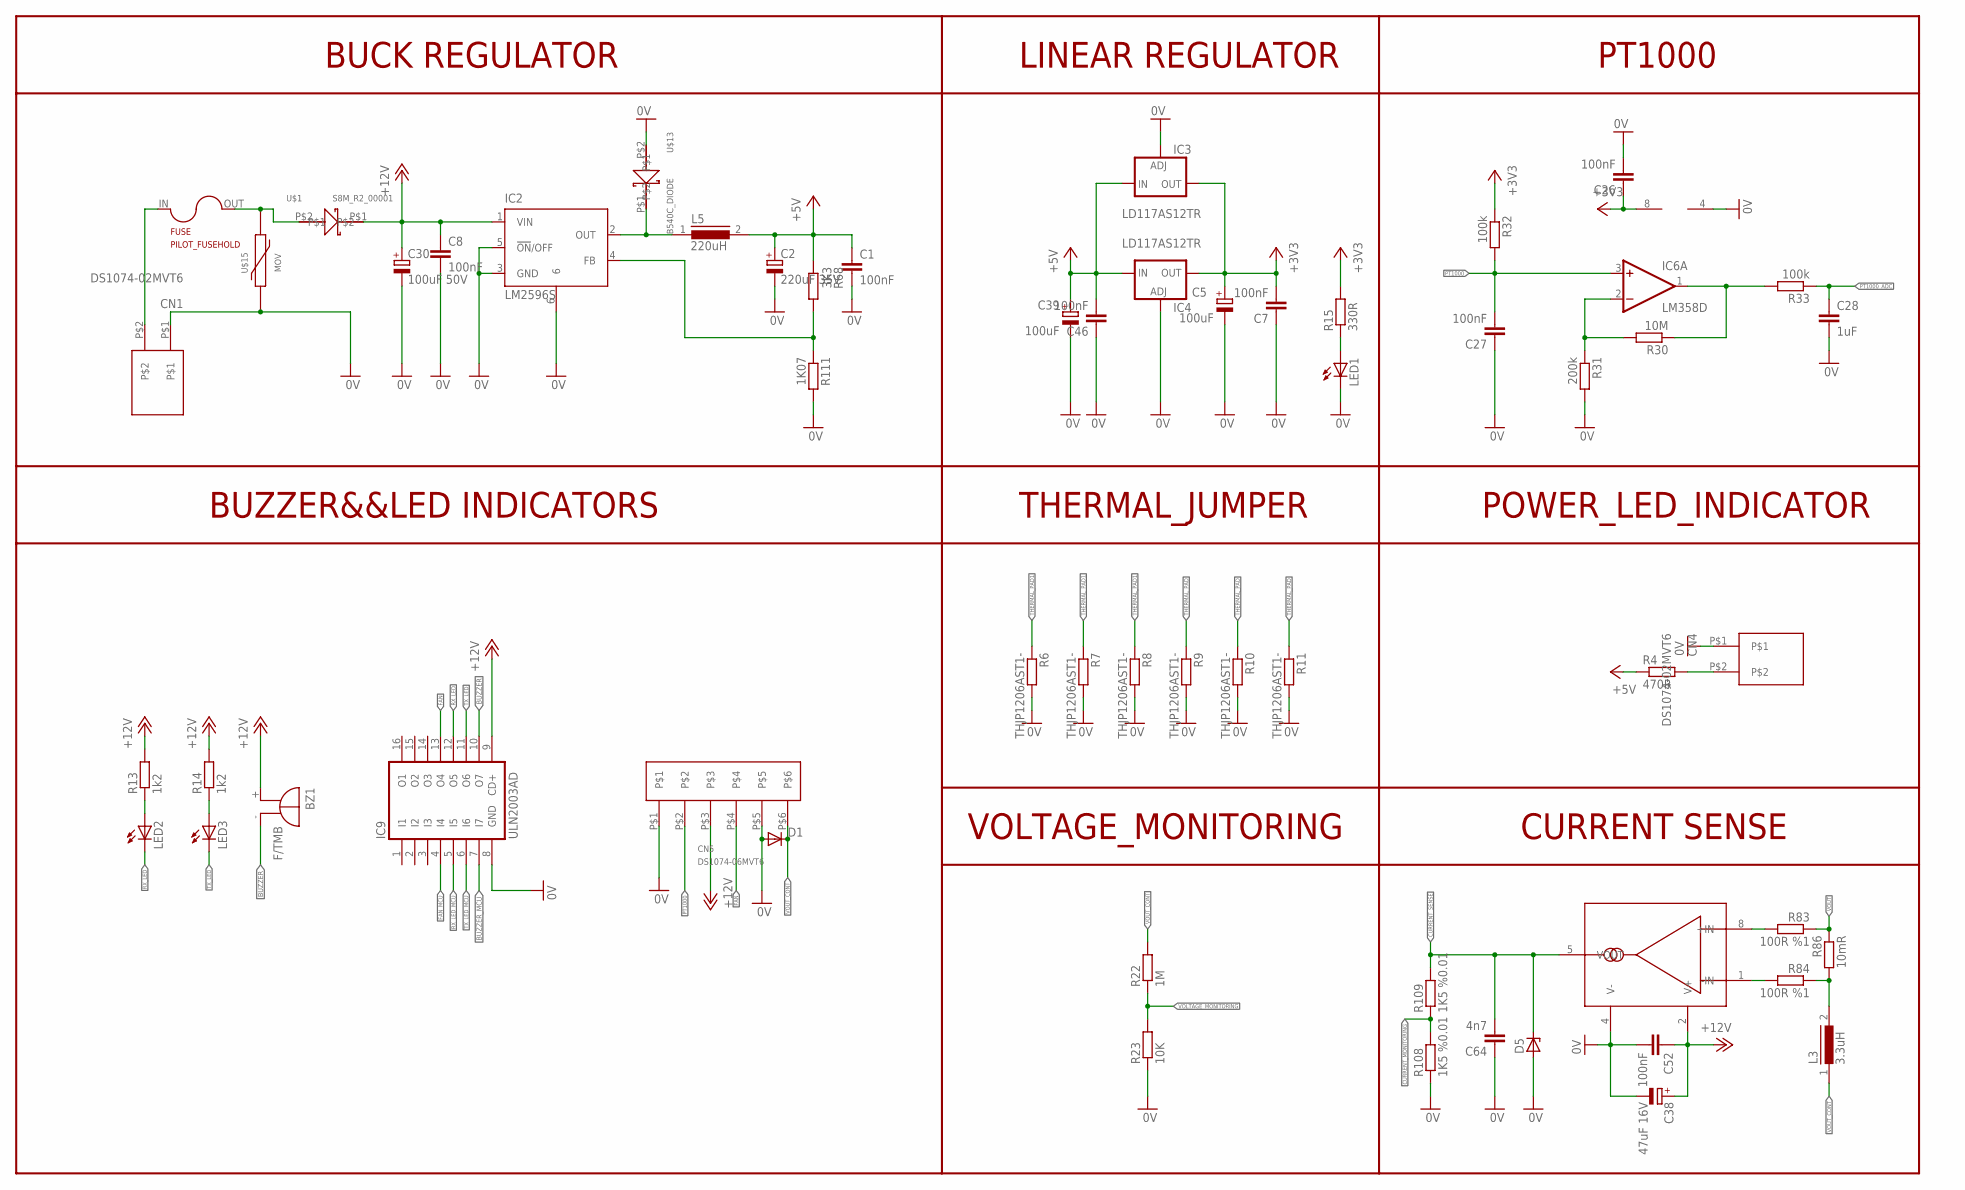
[picture p6: schematic LSR_CNTRL.sch, sheet 1]

Parts:
BZ1: F/TMB
C1, C8, C52: 100nF; C0805
C2: 220uF 35V; 153CLV-0810
C5, C39: 100uF; 153CLV-0605
C7, C26, C27, C46: 100nF; C0603
C28: 1uF; C1206
C30: 100uF 50V; 153CLV-0810
C38: 47uF 16V; B/3528-21R
C64: 4n7; C0805
CN1, CN4: DS1074-02MVT6
CN5: DS1074-06MVT6
D1: DIODE-SMB; SMB
D5: ZENER-DIODESOD80C; SOD80C
FUSE: PILOT_FUSEHOLD; RTM_FUSEHOLD
IC2: LM2596S; TO263-5
IC3, IC4: LD117AS12TR; SOT223
IC6: LM358D; SO08
IC9: ULN2003AD; SO16
L3: 3.3uH; DR127
L5: 220uH; DR125
LED1, LED2, LED3: LEDCHIPLED_0805; CHIPLED_0805
R4: 470R; M0805
R6, R7, R8, R9, R10, R11: THJP1206AST1-; M0805
R13, R14: 1k2; R0603
R15: 330R; R0603
R22: 1M; R0603
R23: 10K; R0603
R30: 10M; R0603
R31: 200k; R0603
R32, R33: 100k; R0603
R68: 3K3; M0805
R83, R84: 100R %1; R0805
R86: 10mR; R2512
R108, R109: 1K5 %0.01; R0603
R111: 1K07; M0805
U$1: S8M_R2_00001; SMC
U$5: LT6105; MSOP-8
U$13: B540C_DIODE; SMC
U$15: MOV-10D201K

Connections:
0V: C1.2, C2.-, C5.-, C7.1, C8.2, C26.2, C27.1, C28.2, C30.-, C38.-, C39.-, C46.1, C52.2, C64.1, CN1.P$1, CN4.P$1, CN5.P$1, CN5.P$5, D1.A, D5.A, IC2.3 (GND), IC2.5 (!ON!/OFF), IC2.6, IC3.1 (ADJ), IC4.1 (ADJ), IC6.4 (V-), IC9.8 (GND), LED1.C, R6.2, R7.2, R8.2, R9.2, R10.2, R11.2, R23.1, R31.2, R108.1, R111.2, U$5.4 (V-), U$13.P$2, U$15.1; also elsewhere on the board
+3V3: C5.+, C7.2, C26.1, IC3.4 (OUT), IC4.4 (OUT), IC6.8 (V+), R15.2, R32.1; also elsewhere on the board
+5V: C1.1, C2.+, C39.+, C46.2, IC3.3 (IN), IC4.3 (IN), L5.2, R4.1, R68.1; also elsewhere on the board
+12V: BZ1.+, C8.1, C30.+, C38.+, C52.1, CN5.P$3, IC2.1 (VIN), IC9.9 (CD+), R13.2, R14.2, U$1.P$1, U$5.2 (V+); also elsewhere on the board
BUZZER: BZ1.-, IC9.10 (O7)
BUZZER_MCU: IC9.7 (I7); also elsewhere on the board
CURRENT_MONITORING: R108.2, R109.1; also elsewhere on the board
CURRENT_SENSE: C64.2, D5.C, R109.2, U$5.5 (VOUT)
FAN: CN5.P$4, IC9.13 (O4)
FAN_MCU: IC9.4 (I4); also elsewhere on the board
unnamed: CN1.P$2, FUSE.IN
unnamed: LED2.A, R13.1
unnamed: LED3.A, R14.1
unnamed: FUSE.OUT, U$1.P$2, U$15.2
unnamed: CN4.P$2, R4.2
unnamed: IC6.2 (-IN), R30.2, R31.1
unnamed: LED1.A, R15.1
unnamed: IC6.1 (OUT), R30.1, R33.2
unnamed: L3.2, R84.1, R86.2
unnamed: R83.2, U$5.8 (+IN)
unnamed: R84.2, U$5.1 (-IN)
unnamed: IC2.2 (OUT), L5.1, U$13.P$1
unnamed: IC2.4 (FB), R68.2, R111.1
PT1000: C27.2, CN5.P$2, IC6.3 (+IN), R32.2
PT1000_ADC: C28.1, R33.1; also elsewhere on the board
RX_LED: IC9.12 (O5), LED2.C
RX_LED_MCU: IC9.5 (I5); also elsewhere on the board
THERMAL_PAD: R9.1, R10.1, R11.1
THERMAL_PAD1: R6.1, R7.1, R8.1
TX_LED: IC9.11 (O6), LED3.C
TX_LED_MCU: IC9.6 (I6); also elsewhere on the board
VOLTAGE_MONITORING: R22.1, R23.2; also elsewhere on the board
VOUT: R83.1, R86.1; also elsewhere on the board
VOUT_CONT: CN5.P$6, D1.C, L3.1, R22.2

Notes on the sheet:
BUCK REGULATOR
LINEAR REGULATOR
PT1000
POWER_LED_INDICATOR
CURRENT SENSE
THERMAL_JUMPER
VOLTAGE_MONITORING
BUZZER&&LED INDICATORS
