batuhankemal/Development-of-an-infrared-array-sensor-integrated-laser-system/Hardware/Electronic Control Unit(ECU) Hardware/LSR_CNTRL.brd

## EAGLE design Hardware/Electronic Control Unit(ECU) Hardware/LSR_CNTRL.brd (continued)

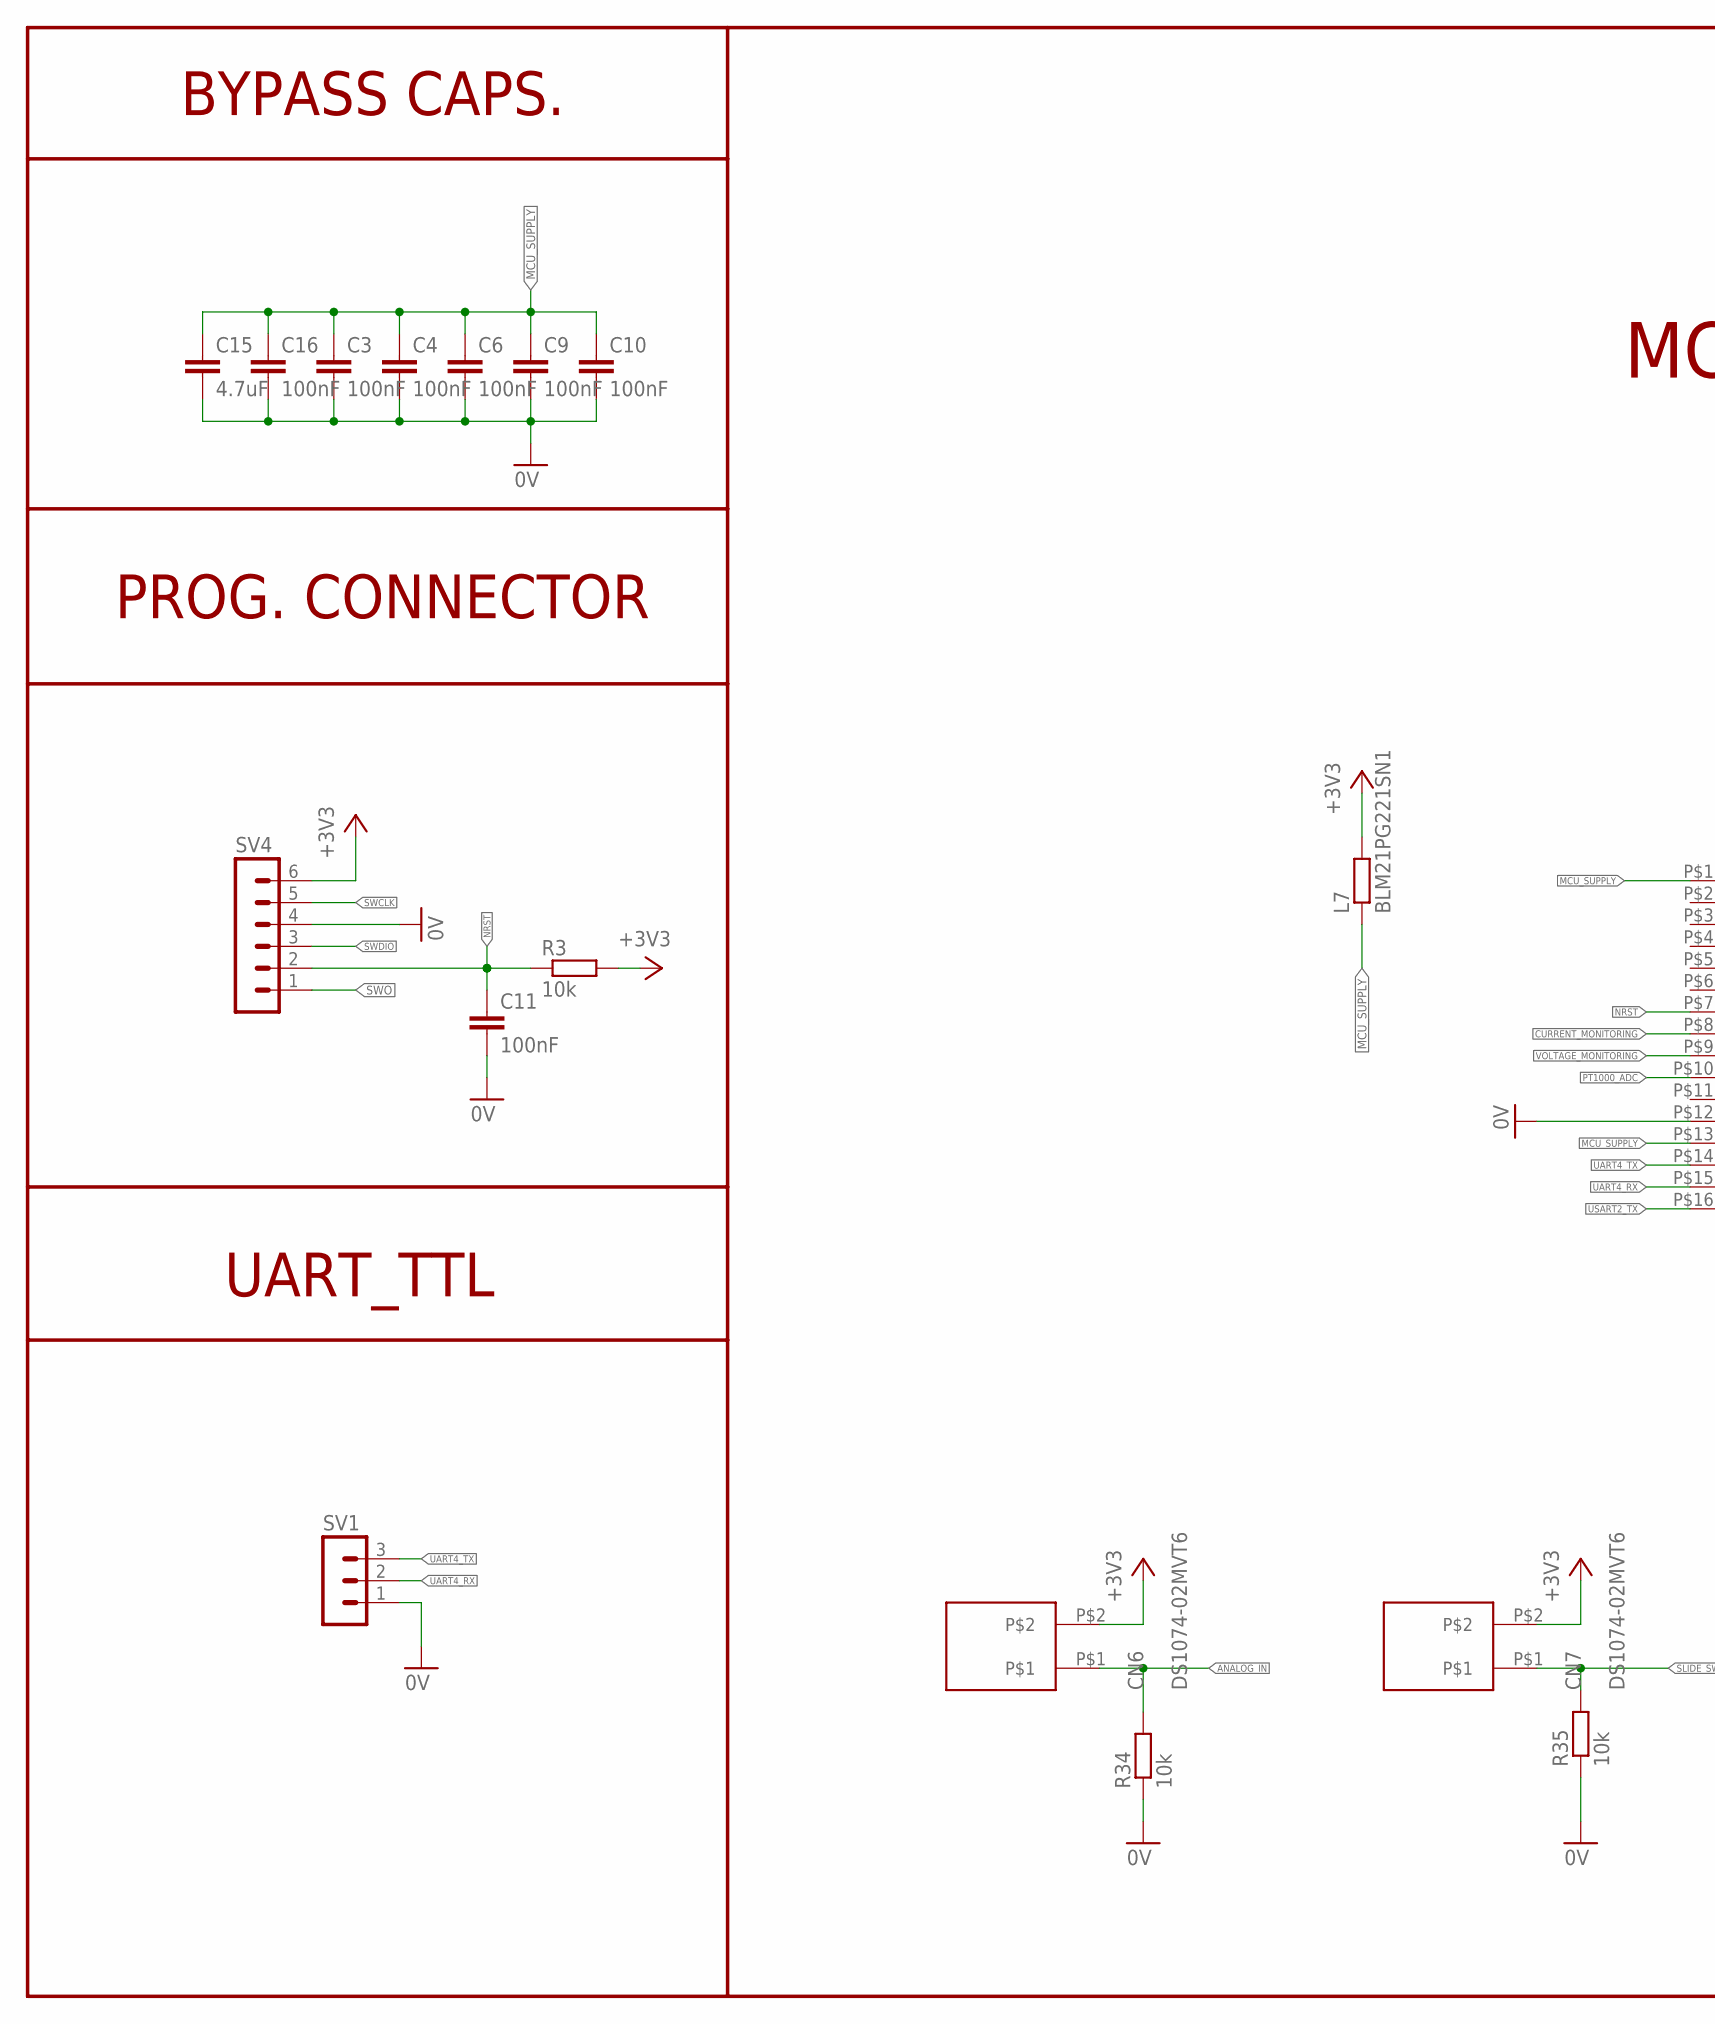
[picture p7: schematic LSR_CNTRL.sch, sheet 2, part in row 1, column 1]

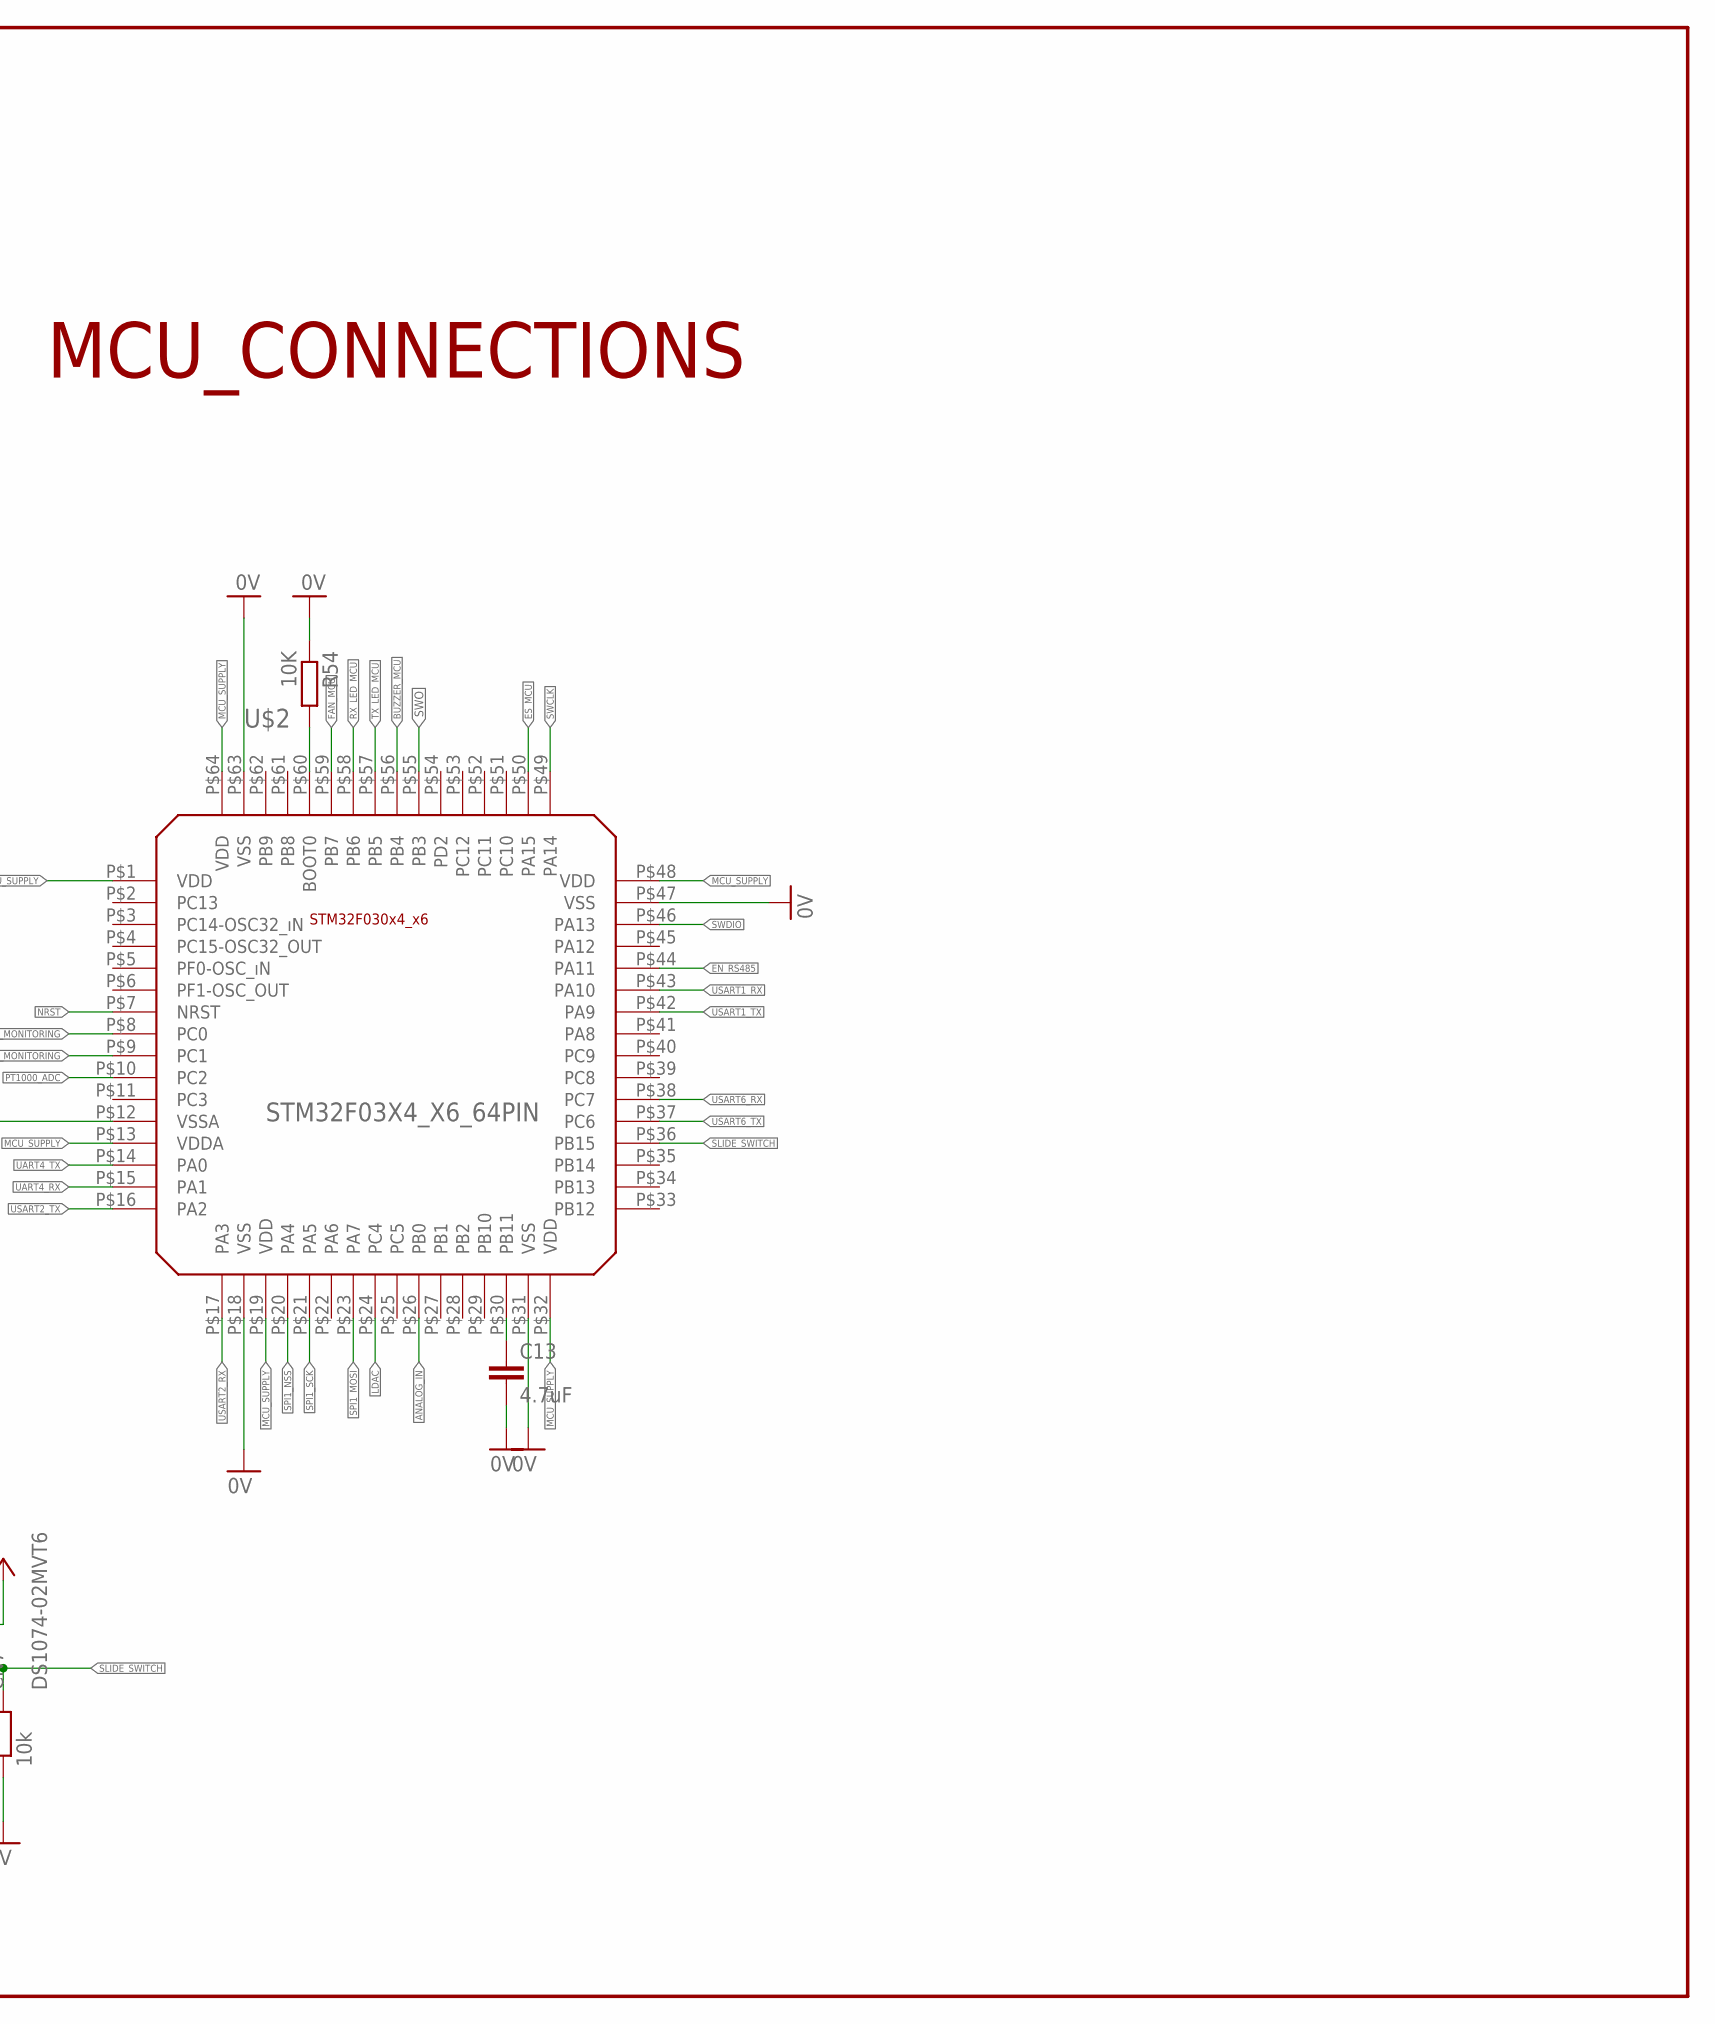
[picture p8: schematic LSR_CNTRL.sch, sheet 2, part in row 1, column 2]

Parts:
C3, C4, C6, C9, C10, C11, C16: 100nF; C0603
C13, C15: 4.7uF; C0805
CN6, CN7: DS1074-02MVT6
L7: BLM21PG221SN1; R0805
R3, R34, R35: 10k; R0603
R54: 10K; R0603
SV1: MA03-1
SV4: MA06-1
U$2: STM32F03X4_X6_64PIN; LQFP64

Connections:
0V: C3.2, C4.2, C6.2, C9.2, C10.2, C11.2, C13.2, C15.2, C16.2, R34.1, R35.1, R54.1, SV1.1, SV4.4, U$2.P$12 (VSSA), U$2.P$18 (VSS), U$2.P$31 (VSS), U$2.P$47 (VSS), U$2.P$63 (VSS); also elsewhere on the board
+3V3: CN6.P$2, CN7.P$2, L7.2, R3.2, SV4.6; also elsewhere on the board
ANALOG_IN: CN6.P$1, R34.2, U$2.P$26 (PB0)
BUZZER_MCU: U$2.P$56 (PB4); also elsewhere on the board
CURRENT_MONITORING: U$2.P$8 (PC0); also elsewhere on the board
EN_RS485: U$2.P$44 (PA11); also elsewhere on the board
ES_MCU: U$2.P$50 (PA15); also elsewhere on the board
FAN_MCU: U$2.P$59 (PB7); also elsewhere on the board
LDAC: U$2.P$24 (PC4); also elsewhere on the board
MCU_SUPPLY: C3.1, C4.1, C6.1, C9.1, C10.1, C15.1, C16.1, L7.1, U$2.P$1 (VDD), U$2.P$13 (VDDA), U$2.P$19 (VDD), U$2.P$32 (VDD), U$2.P$48 (VDD), U$2.P$64 (VDD)
unnamed: C13.1, U$2.P$30 (PB11)
unnamed: R54.2, U$2.P$60 (BOOT0)
NRST: C11.1, R3.1, SV4.2, U$2.P$7 (NRST)
PT1000_ADC: U$2.P$10 (PC2); also elsewhere on the board
RX_LED_MCU: U$2.P$58 (PB6); also elsewhere on the board
SLIDE_SWITCH: CN7.P$1, R35.2, U$2.P$36 (PB15)
SPI1_MOSI: U$2.P$23 (PA7); also elsewhere on the board
SPI1_NSS: U$2.P$20 (PA4); also elsewhere on the board
SPI1_SCK: U$2.P$21 (PA5); also elsewhere on the board
SWCLK: SV4.5, U$2.P$49 (PA14)
SWDIO: SV4.3, U$2.P$46 (PA13)
SWO: SV4.1, U$2.P$55 (PB3)
TX_LED_MCU: U$2.P$57 (PB5); also elsewhere on the board
UART4_RX: SV1.2, U$2.P$15 (PA1)
UART4_TX: SV1.3, U$2.P$14 (PA0)
USART1_RX: U$2.P$43 (PA10); also elsewhere on the board
USART1_TX: U$2.P$42 (PA9); also elsewhere on the board
USART2_RX: U$2.P$17 (PA3); also elsewhere on the board
USART2_TX: U$2.P$16 (PA2); also elsewhere on the board
USART6_RX: U$2.P$38 (PC7); also elsewhere on the board
USART6_TX: U$2.P$37 (PC6); also elsewhere on the board
VOLTAGE_MONITORING: U$2.P$9 (PC1); also elsewhere on the board

Notes on the sheet:
BYPASS CAPS.
PROG. CONNECTOR
MCU_CONNECTIONS
UART_TTL

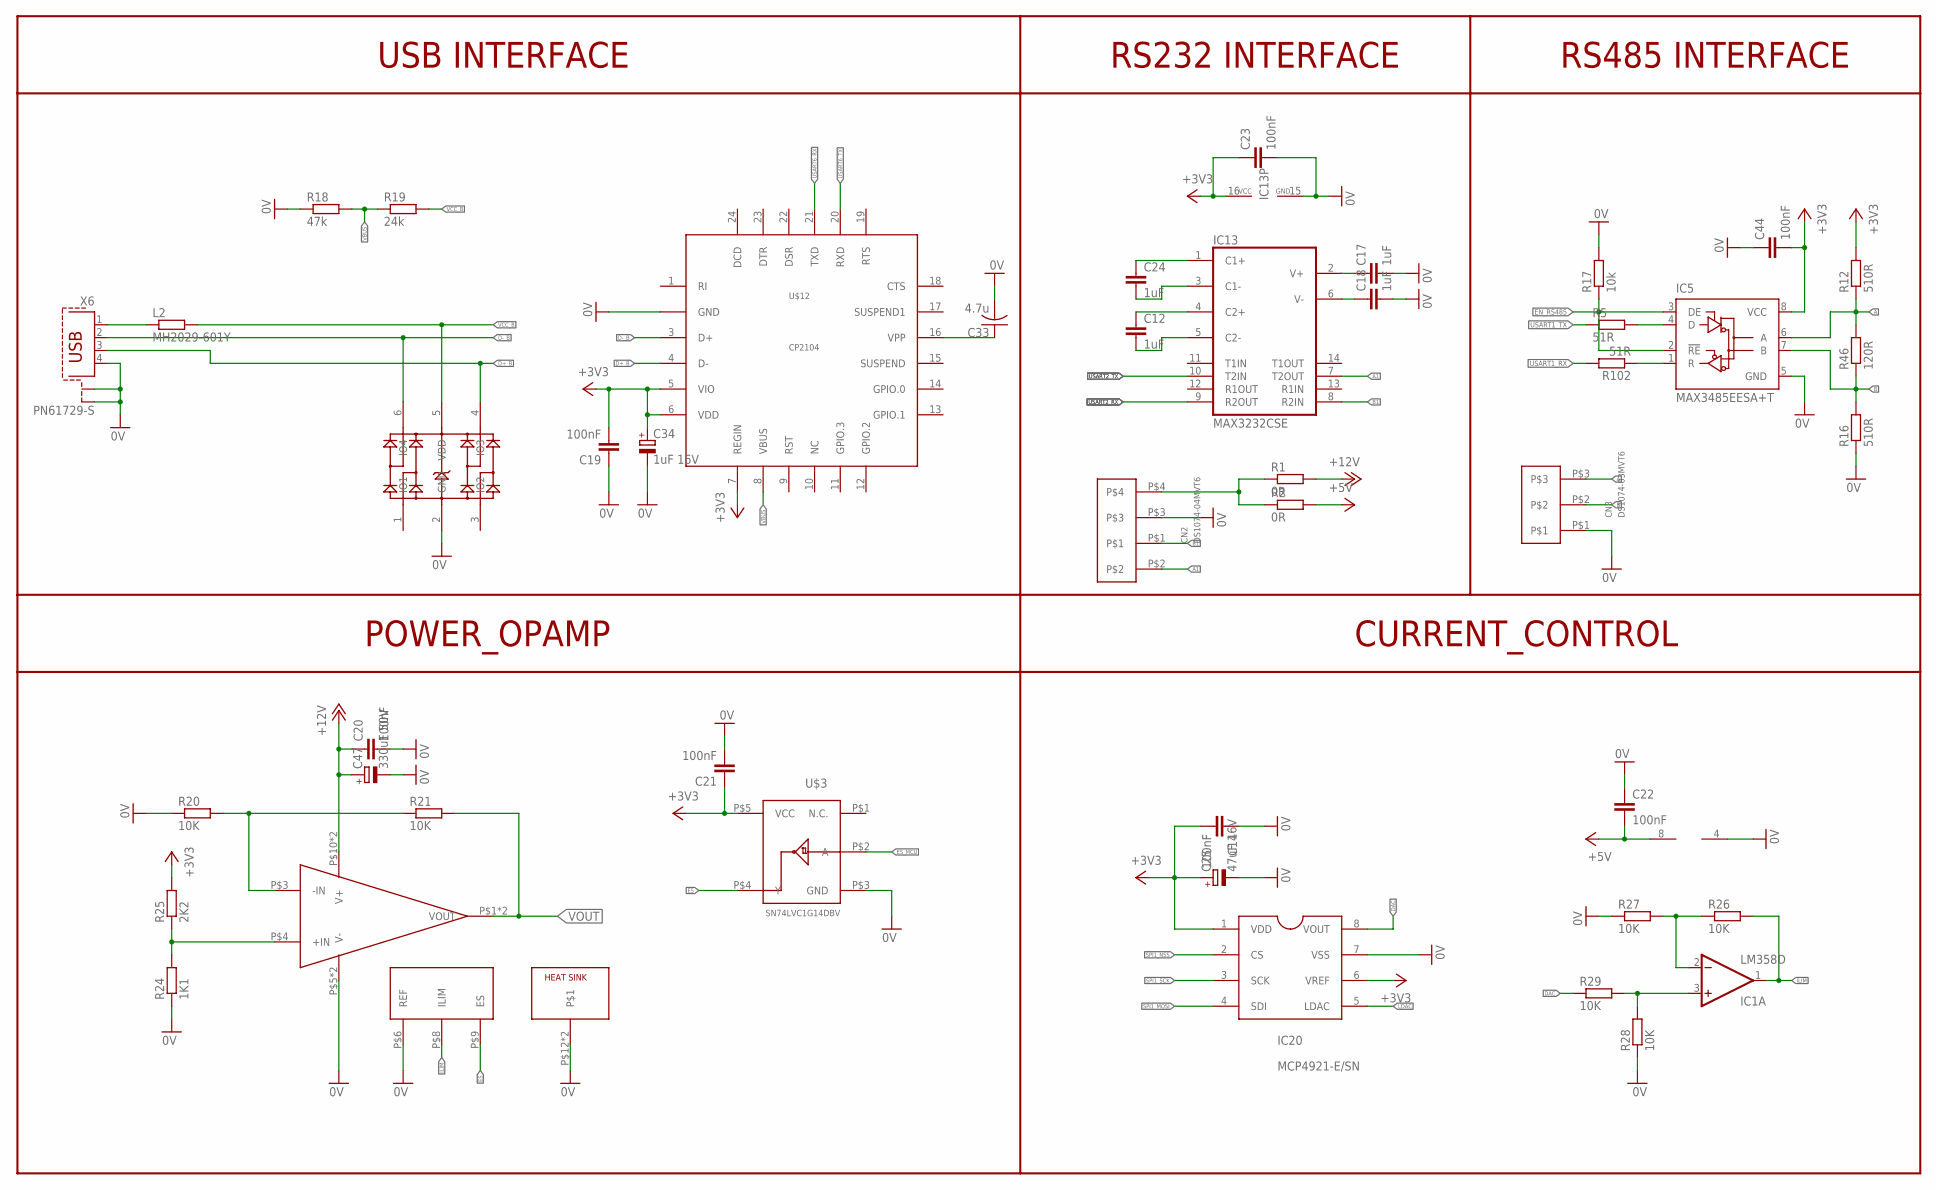
[picture p9: schematic LSR_CNTRL.sch, sheet 3]

Parts:
C12, C17, C18, C24: 1uF; C1206
C14, C19, C20, C21, C22, C23, C44: 100nF; C0603
C25: 47uF 16V; B/3528-21R
C33: 4.7u; C0805
C34: 1uF 16V; SMC_Z
C47: 330uF 50V; E5-10,5
CN2: DS1074-04MVT6
CN3: DS1074-03MVT6
IC1: LM358D; SO08
IC5: MAX3485EESA+T; D_R-PDSO-G8
IC13: MAX3232CSE; SO16
IC20: MCP4921-E/SN; SO-08-MCP
L2: MH2029-601Y; R0805
OPAMP1: OPA549MKVC
R1, R2: 0R; R0805
R5, R102: 51R; R0603
R12, R16: 510R; R0603
R17: 10k; R0603
R18: 47k; R0805
R19: 24k; R0805
R20, R21, R26, R27, R28, R29: 10K; R0805
R24: 1K1; R0805
R25: 2K2; R0805
R46: 120R; R0603
TVS1: 824001; SOT23-6
U$3: SN74LVC1G14DBV; SOT-23-DBV
U$12: CP2104
X6: PN61729-S

Connections:
0V: C14.1, C17.2, C18.2, C19.1, C20.2, C21.2, C22.1, C23.2, C25.-, C33.2, C34.-, C44.1, C47.-, CN2.P$3, CN3.P$1, IC1.4 (V-), IC5.5 (GND), IC13.15 (GND), IC20.7 (VSS), OPAMP1.P$5 (V-), OPAMP1.P$6 (REF), OPAMP1.P$7 (V-), OPAMP1.P$12, OPAMP1.P$13, R16.1, R17.2, R18.1, R20.1, R24.1, R27.1, R28.1, TVS1.2 (GND), U$3.P$3 (GND), U$12.2 (GND), U$12.GND1 (GND), X6.4, X6.S1, X6.S2; also elsewhere on the board
+3V3: C14.2, C19.2, C21.1, C23.1, C25.+, C34.+, C44.2, IC5.8 (VCC), IC13.16 (VCC), IC20.1 (VDD), IC20.6 (VREF), R12.2, R25.2, U$3.P$5 (VCC), U$12.5 (VIO), U$12.6 (VDD), U$12.7 (REGIN); also elsewhere on the board
+5V: C22.2, IC1.8 (V+), R2.2; also elsewhere on the board
+12V: C20.1, C47.+, OPAMP1.P$10 (V+), OPAMP1.P$11 (V+), R1.2; also elsewhere on the board
A: CN3.P$3, IC5.6 (A), R12.1, R46.2
A1: CN2.P$2, IC13.7 (T2OUT)
B: CN3.P$2, IC5.7 (B), R16.2, R46.1
B1: CN2.P$1, IC13.8 (R2IN)
D+_B: TVS1.4 (IO3), U$12.4 (D-), X6.3
D-_B: TVS1.6 (IO4), U$12.3 (D+), X6.2
DAC: IC20.8 (VOUT), R29.1
EN_RS485: IC5.2 (!RE), IC5.3 (DE), R17.1; also elsewhere on the board
ES: OPAMP1.P$9 (ES), U$3.P$4 (Y)
ES_MCU: U$3.P$2 (A); also elsewhere on the board
ILIM: IC1.1 (OUT), OPAMP1.P$8 (ILIM), R26.2
LDAC: IC20.5 (LDAC); also elsewhere on the board
unnamed: C18.1, IC13.6 (V-)
unnamed: OPAMP1.P$3 (-IN), R20.2, R21.1
unnamed: IC1.2 (-IN), R26.1, R27.2
unnamed: OPAMP1.P$4 (+IN), R24.2, R25.1
unnamed: IC1.3 (+IN), R28.2, R29.2
unnamed: IC5.4 (D), R5.2
unnamed: C33.1, U$12.16 (VPP)
unnamed: L2.1, X6.1
unnamed: C24.1, IC13.1 (C1+)
unnamed: C24.2, IC13.3 (C1-)
unnamed: IC5.1 (R), R102.1
unnamed: C12.1, IC13.4 (C2+)
unnamed: C12.2, IC13.5 (C2-)
unnamed: C17.1, IC13.2 (V+)
SPI1_MOSI: IC20.4 (SDI); also elsewhere on the board
SPI1_NSS: IC20.2 (CS); also elsewhere on the board
SPI1_SCK: IC20.3 (SCK); also elsewhere on the board
SUPPLY: CN2.P$4, R1.1, R2.1
USART1_RX: R102.2; also elsewhere on the board
USART1_TX: R5.1; also elsewhere on the board
USART2_RX: IC13.9 (R2OUT); also elsewhere on the board
USART2_TX: IC13.10 (T2IN); also elsewhere on the board
USART6_RX: U$12.21 (TXD); also elsewhere on the board
USART6_TX: U$12.20 (RXD); also elsewhere on the board
VBUS: R18.2, R19.1, U$12.8 (VBUS)
VCC_B: L2.2, R19.2, TVS1.5 (VDD)
VOUT: OPAMP1.P$1 (VOUT), OPAMP1.P$2 (VOUT), R21.2; also elsewhere on the board

Notes on the sheet:
USB INTERFACE
RS232 INTERFACE
RS485 INTERFACE
CURRENT_CONTROL
POWER_OPAMP

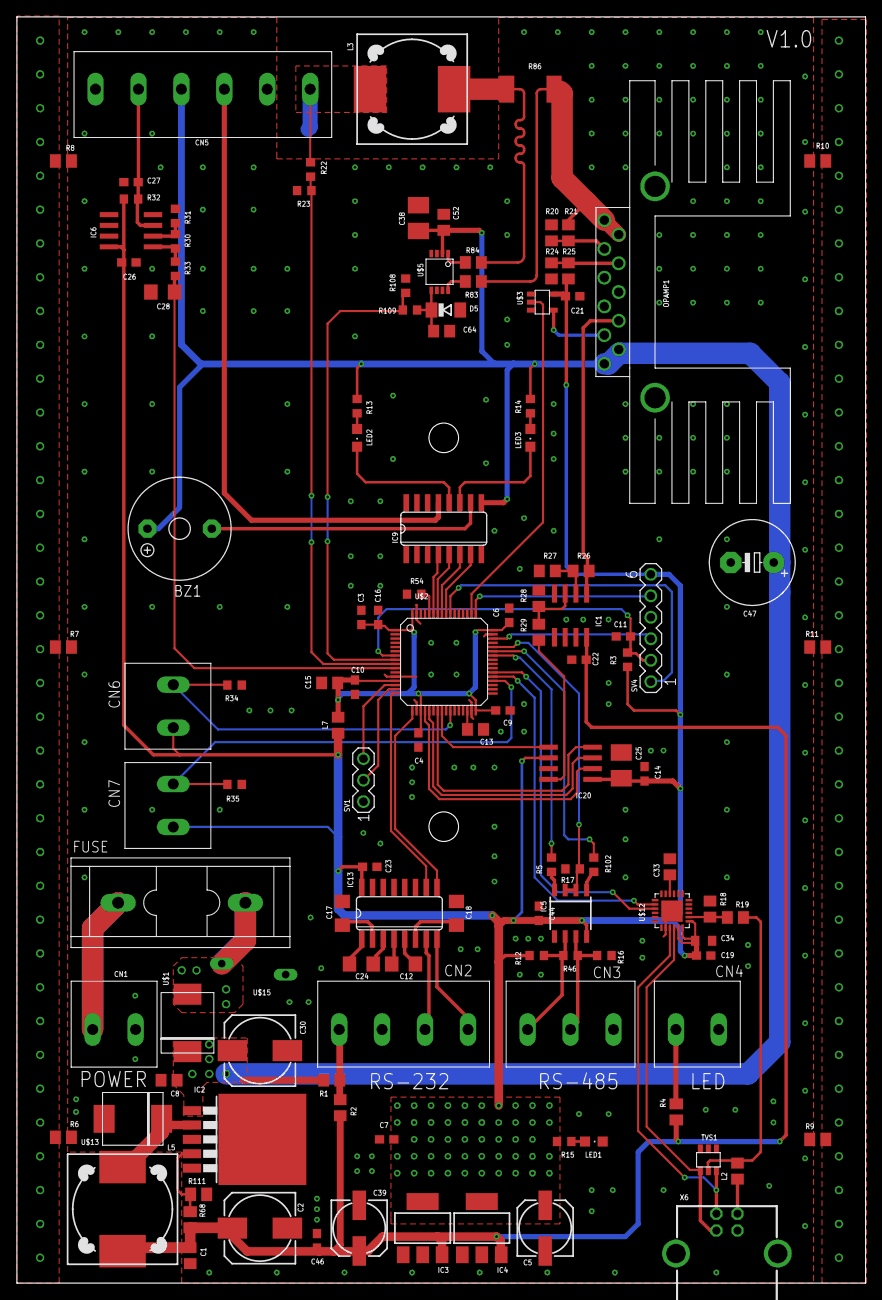
[picture p10: board LSR_CNTRL.brd from above]

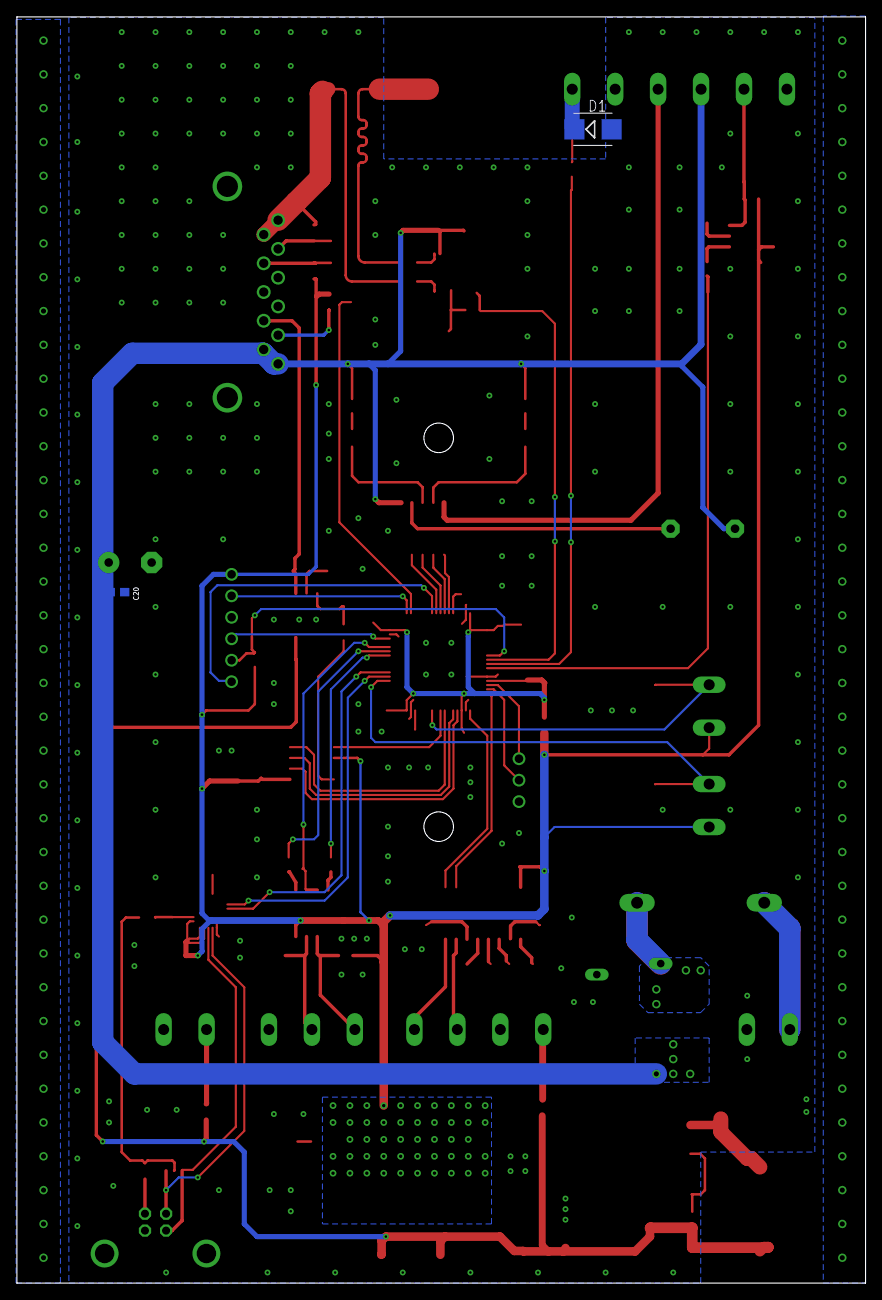
[picture p11: board LSR_CNTRL.brd from below]

Board: 2 copper layers, 100.4 x 149.8 mm, 122 parts (2 on the bottom side), 83 nets.
