batuhankemal/Development-of-an-infrared-array-sensor-integrated-laser-system/Software/Electronic Control Unit(ECU) Software/Core/Inc/main.h

#define SPI_CS_Pin GPIO_PIN_4
#define SPI_CS_GPIO_Port GPIOA
#define LDAC_Pin GPIO_PIN_4
#define LDAC_GPIO_Port GPIOC
#define DEV_IN_Pin GPIO_PIN_0
#define DEV_IN_GPIO_Port GPIOB
#define SLIDE_SW_Pin GPIO_PIN_15
#define SLIDE_SW_GPIO_Port GPIOB
#define RS_EN_Pin GPIO_PIN_11
#define RS_EN_GPIO_Port GPIOA
#define ES_MCU_Pin GPIO_PIN_15
#define ES_MCU_GPIO_Port GPIOA
#define BUZZER_Pin GPIO_PIN_4
#define BUZZER_GPIO_Port GPIOB
#define RX_LED_Pin GPIO_PIN_5
#define RX_LED_GPIO_Port GPIOB
#define TX_LED_Pin GPIO_PIN_6
#define TX_LED_GPIO_Port GPIOB
#define FAN_Pin GPIO_PIN_7
#define FAN_GPIO_Port GPIOB
