batuhankemal/Development-of-an-infrared-array-sensor-integrated-laser-system/(notices)

Notices in the files:
Software/Electronic Control Unit(ECU) Software/Core/Inc/main.h:
Copyright (c) 2023 STMicroelectronics.
All rights reserved.
This software is licensed under terms that can be found in the LICENSE file
